haki6661/massarbeit-waage/README.md

# Maßarbeit - Waagen-Firmware

Firmware fuer eine **eigene Praezisionswaage** fuer das Maßarbeit-Trinkspiel,
basierend auf [WeighMyBru2](https://github.com/031devstudios/weighmybru2). Ein
Board macht alles: Waegezelle auslesen, BLE-Service fuer die Handy-Web-App
(siehe Schwesterprojekt "Maßarbeit App"), Anzeige.

**Zwei Geraetevarianten, eine Codebasis:** die **Maßarbeit Vision** mit TFT
und die **Maßarbeit** ohne Display. Im Code und in dieser Datei heissen sie
kurz "Vision" und "Basis".

| | Maßarbeit Vision | Maßarbeit |
|---|---|---|
| Board | LilyGO T-Display S3 (ESP32-S3, Xtensa) | LilyGO T-OI Plus V1.3 / "mini D1 PLUS" (ESP32-C3, RISC-V) |
| Anzeige | 1,9" ST7789-TFT 170x320 | eine Status-LED |
| Taster | zwei | keine (Bedienung über die App) |
| Akku | ja | ja (16340-Halter + Laderegler an Bord) |
| Build-Target | `t-display-s3` | `t-oi-plus` |
| BLE-Name | `Massarbeit-Vision` | `Massarbeit` |

Der geteilte Anteil ist gross: Waegezellen-Auswertung, das komplette
BLE-Protokoll, Firmware-Update per BLE, Kalibrierung und Deep Sleep sind
identisch - variantenspezifisch sind nur Pins, Anzeige, Tastenanzahl und der
Weckmechanismus aus dem Deep Sleep. Eine gemeinsame `.bin` kann es trotzdem
nicht geben: der S3 ist ein Xtensa-Kern, der C3 ein RISC-V - schon die
Befehlssaetze sind verschieden. Also zwei Build-Targets aus einer Codebasis
(siehe `include/BoardConfig.h`). Die App dagegen erkennt beim Verbinden
selbst, welches Modell dranhaengt (Geraete-Info-Characteristic, siehe
Abschnitt "BLE").

Die Modellkennungen (`t-display-s3`, `t-oi-plus`) benennen bewusst die
HARDWARE, nicht das Produkt: unter ihnen sucht die App im Manifest das
passende Release, sie muessen also stabil bleiben, auch wenn sich ein
Produktname wieder aendert.

Aktueller Stand: HX711-Handling + Kalibrierroutine + BLE-Gewichts-/Akkuservice
(inkl. Fernsteuerung der Anzeige durch die App, siehe Abschnitt "BLE"
weiter unten) + TFT-Anzeige mit Spieler-Badge und spielspezifischen
Away-Animationen + Pixel-Art-Sprite-Bootanimation (siehe `data/`) +
Status-LED-Anzeige derselben Zustände auf der Basis + WS2812B-Lichtleiste
(Basis) inkl. Formel-1-Startampel + Taster-Bedienung und Deep-Sleep-
Stromsparmodus (nur Vision) + Firmware-Update direkt aus der App per BLE
(kein WLAN am Partyort nötig, siehe Abschnitt "Firmware-Update per BLE"
weiter unten) + Entwicklungs-OTA per WLAN (nur Vision). Die Away-/Ergebnis-
Animationen (nicht der Boot) sind weiterhin rein prozedural aus
Linien/Kreisen/Formen, kein Sprite noetig.

**UI-Relaunch (Firmware 1.5.0):** Die TFT-Anzeige tragt jetzt dieselbe
Farbsprache wie die neu gestaltete Handy-App (dunkler Grund, ein Akzent
"Sonnenuntergang", success/danger/warning-Statusfarben - siehe
`TftDisplay::begin()`), je Spiel eine eigene Kennfarbe (statt vorher immer
Olivgruen) sowie eine kraeftige, geometrische Bold-Schrift
(`FreeSansBold10pt7b`, `include/`) fuer Spielname/Cue-Titel statt des
technischen 5x7-Pixel-Fonts. Ausserdem: die Puls-/Away-Animationen
(BEREIT/VOLLTREFFER/Away-Motive) zeichnen unveraenderliche Bildteile nur noch
einmal und radieren pro Frame nur noch die tatsaechlich bewegte Flaeche
("Dirty Rect") statt bei jedem ~150ms-Redraw den kompletten Bildschirm zu
leeren - behebt das sichtbare Schwarz-Aufblitzen waehrend laufender
Animationen.

## Hardware

Beide Varianten teilen sich HX711 + 3kg-Single-Point-Waegezelle und einen
1S-LiPo am jeweils eingebauten Laderegler. Die Pinbelegungen stehen als
Board-Profile in `include/boards/`.

### Maßarbeit Vision: LilyGO T-Display S3

| Zweck | GPIO |
|---|---|
| HX711 DOUT / SCK | 1 / 2 |
| Taste 1 (BOOT) / Taste 2 | 0 / 14 |
| Display (8-Bit-Parallelbus, siehe unten) | 5,6,7,8,9,38–48 |
| Peripherie-Power-Enable | 15 |
| Batteriespannung (ADC) | 4 |

Angeschlossen wird dabei nur der HX711 (Waegezelle) - Taster, Display, Power-
Enable und Batterie-ADC sind bereits fest auf dem Board verdrahtet:

HX711-Anschluss Maßarbeit Vision

Quelle: [Xinyuan-LilyGO/T-Display-S3](https://github.com/Xinyuan-LilyGO/T-Display-S3)
README-Pinout-Tabelle. **Wichtig:** GPIO5/6 sind bei WeighMyBru2s Original-
Boards der HX711, hier aber LCD RST/CS - deshalb HX711 auf GPIO1/2 verlegt.
Das ST7789-Display haengt an einem **8-Bit-Parallelbus** (Intel-8080-Timing),
nicht an SPI - daher `Arduino_GFX` (`Arduino_ESP32PAR8Q`-Bus) statt
`TFT_eSPI`/SPI-Displaytreiber.

### Basisvariante: LilyGO T-OI Plus V1.3 ("mini D1 PLUS")

ESP32-C3 (RISC-V), 4MB Flash, CH340C als USB-Serial-Wandler (kein nativer
USB am Chip - Serial laeuft ueber UART0), Halter fuer eine 16340-Zelle mit
Laderegler, Power-Schalter, Reset-Taster. PlatformIO-Boardprofil
`ttgo-t-oi-plus`.

| Zweck | GPIO | Anmerkung |
|---|---|---|
| HX711 DOUT / SCK | 6 / 7 | auf der Stiftleiste (MTCK/MTDO), kein Strapping-Pin |
| WS2812B-Datenleitung | 4 | über 300-500Ω, LEDs an `5V`/`GND` des Headers |
| Status-LED | 3 | Onboard (`LED_BUILTIN` der Arduino-Variante), nicht herausgefuehrt |
| Batteriespannung (ADC) | 2 | ADC1_CH2, Onboard-Spannungsteiler (Faktor 2) |

Angeschlossen werden hier der HX711 und die LED-Leiste - die Status-LED und
der Batterie-ADC haengen bereits fest am Board. **Einen Taster gibt es
nicht:** ein/aus macht der Schiebeschalter des Boards, alles andere die App.

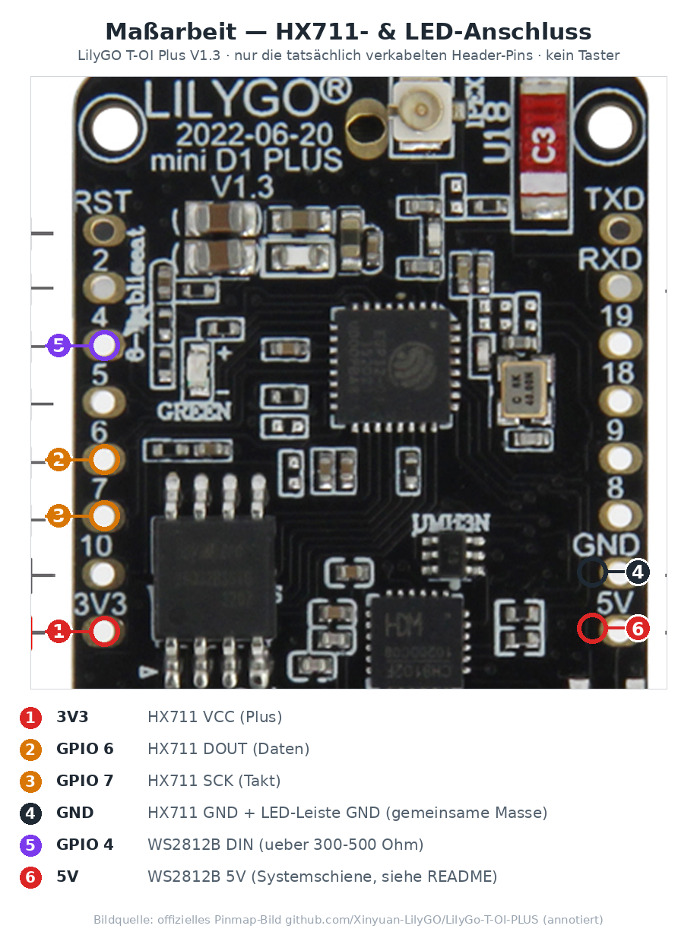
[picture p1: docs/pinout/massarbeit-basis-pinout.png]
HX711-Anschluss Maßarbeit


Quellen: [Xinyuan-LilyGO/LilyGo-T-OI-PLUS](https://github.com/Xinyuan-LilyGO/LilyGo-T-OI-PLUS)
(Pinmap-Bild + `example/battery_voltage`) und die Arduino-Variante
`ttgo-t-oi-plus` (`BAT_ADC_PIN = 2`, `LED_BUILTIN = 3`).

Drei Randbedingungen des C3 bestimmen die Pinwahl - **nicht** umsortieren,
ohne sie zu pruefen:

- **GPIO2/8/9 sind Strapping-Pins** (GPIO8 traegt auf diesem Board sogar den
  Aufdruck "Boot") - dort gehoert nichts hin, was beim Einschalten einen
  definierten Pegel erzwingt, sonst bootet der Chip womoeglich in den
  Flash-Download-Modus statt in die Firmware.
- **Nur GPIO0-5 sind RTC-faehig**, und nur die koennten aus einem Deep Sleep
  aufwecken. Fuer die Basis ist das gegenstandslos (kein Taster, kein Deep
  Sleep), aber gut zu wissen, falls die Variante das je bekommen soll:
  herausgefuehrt sind davon GPIO2, 4 und 5, und GPIO5 ist frei.
- **GPIO20/21 sind UART0** und gehen an den CH340 - freilassen, sonst ist der
  Serial-Monitor weg. (GPIO18/19, am C3 sonst der native USB, sind hier frei:
  das Board fuehrt sie als I2C/Grove heraus.)

Der C3 kennt ausserdem **kein `ext0`**: statt
`esp_sleep_enable_ext0_wakeup()` weckt ihn
`esp_deep_sleep_enable_gpio_wakeup()`, und die Aufwach-Ursache heisst
`ESP_SLEEP_WAKEUP_GPIO` statt `ESP_SLEEP_WAKEUP_EXT0` (siehe
`enterDeepSleep()`/`setup()` in `main.cpp` - dort werden beide geprueft).
Auch die `rtc_gpio_*`-Funktionen gibt es auf dem C3 nicht, Pullups laufen
ueber den normalen GPIO-Treiber.

Eine Annahme ist beim ersten Aufbau kurz gegenzupruefen und einzeilig
korrigierbar: **die LED-Polaritaet**. `MASSARBEIT_STATUS_LED_ACTIVE_LOW`
steht auf `0` (HIGH schaltet ein); leuchtet die LED genau invers zu dem, was
das Serial-Log sagt, auf `1` aendern.

## Was aus WeighMyBru2 uebernommen wurde

| Modul | Status |
|---|---|
| `Scale.h/.cpp` (HX711, Smart-Filter, NVS-Kalibrierung) | 1:1 portiert, nur FlowRate-Kopplung entfernt |
| BLE-Service (NimBLE, eigene Service-UUID) | Nur das simple "Bean Conqueror"-Float-Format uebernommen (siehe `include/Config.h`), GaggiMate-Protokoll bewusst weggelassen |
| Kalibrier-Workflow (`Faktor = Rohwert / bekanntes Gewicht`) | Logik uebernommen, ueber Serial bzw. App statt Web-Formular |
| Display, Touch-Sensoren, FlowRate, WebServer/WiFiManager, ESP-NOW-Relais | Nicht uebernommen (siehe Architektur-Ueberblick weiter oben im Chat) - fuer Maßarbeit nicht relevant |

## Projektstruktur

```
platformio.ini            <- zwei Build-Targets (+ Dev-OTA-Target)
include/
  BoardConfig.h        <- Dispatcher: waehlt das Board-Profil zur Variante
  boards/
    t_display_s3.h       <- Pins + Faehigkeiten der Vision
    t_oi_plus.h    <- Pins + Faehigkeiten der Basis
  Config.h              <- BLE-UUIDs, Kalibrier-Default, Dev-WLAN/OTA-Zugangsdaten
src/
  main.cpp              <- verdrahtet alle Module
  Scale.h/.cpp           <- HX711 (aus WeighMyBru2 portiert)
  BleWeightService.h/.cpp <- NimBLE-Service: Gewicht + Akkustand (Notify) + Tare/Anzeige-Kommandos (Write) + Geraete-Info
  Buttons.h/.cpp          <- physische Taster (OneButton-Lib), nur Vision
  DeviceUi.h              <- waehlt TftDisplay oder LedStatusUi je Variante
  DeviceUiTypes.h         <- RemoteCue/GameKind/LocalScreen (beide Varianten)
  TftDisplay.h/.cpp       <- nur Vision: Arduino_GFX-Ausgabe (Status,
                            Spieler-Badge, spielspezifische Away-Animationen,
                            Sprite-Bootanimation aus SPIFFS)
  LedStatusUi.h/.cpp      <- nur Basis: dieselben Zustaende als LED-Muster
  LedRing.h/.cpp          <- WS2812B-Lichtring im Deckel: beide Varianten,
                            vorbereitet und standardmaessig AUS
                            (siehe "LED-Ring nachruesten")
  Battery.h/.cpp          <- Akkuspannung (kalibrierter ADC, aus LilyGOs Beispiel) + Prozent-Schaetzung
  CalibrationRoutine.h/.cpp <- interaktive Kalibrierung ueber Serial
  OtaUpdater.h/.cpp        <- Firmware-Update per BLE (Chunks -> Update.h)
  DevOta.h/.cpp           <- WLAN + ArduinoOTA, nur Vision/Entwicklung
scripts/
  release.py             <- baut beide Varianten und schreibt das Manifest
data/
  f000.raw … f049.raw     <- Boot-Sprite-Frames (SPIFFS, siehe data/README.md)
  pal.raw                 <- gemeinsame 256-Farben-Palette dafuer
firmware/
  manifest.json          <- Version + Groesse + MD5 je Variante
  t-display-s3.bin        <- Release-Binary Vision (App laedt es per BLE)
  t-oi-plus.bin           <- Release-Binary Basis
```

## Bedienung

### Maßarbeit Vision (zwei Taster)

- **Taste 1** kurz: Geräte-Spielauswahl, nächstes Spiel
- **Taste 1** lang (~2s): sofort Deep Sleep (Display aus, ~wenige µA statt 60-150+ mA aktiv)
- **Taste 2** kurz: Auswahl bestätigen
- **Taste 2** lang (~1,5s): Kalibrierroutine starten (siehe unten)
- **Taste 2 drücken, während die Waage schläft**: aufwecken (kompletter Neustart der Firmware - kein spezieller Resume-Pfad, das ist bei ESP32-Deep-Sleep so vorgesehen)
- **Taste 2 beim Booten halten**: WLAN + ArduinoOTA aktivieren (nur Entwicklung, siehe unten)

Aufwecken geht bewusst nur über Taste 2 (GPIO14), nicht über Taste 1: GPIO0
(Taste 1) ist der BOOT-Strapping-Pin, wäre er beim Aufwach-Bootvorgang noch
gedrückt, könnte der Chip in den Flash-Download-Modus statt in die Firmware
starten.

### Basisvariante (ohne Taster)

Die Basis hat **keinen Taster**. Ein- und ausgeschaltet wird sie über den
Schiebeschalter des Boards, alles andere läuft über die App:

| | |
|---|---|
| Ein/Aus | Schiebeschalter des Boards (bzw. ein extern parallel dazu gelegter) |
| Tara | App, BLE-Kommando `0x01` |
| Kalibrierung | App (`0x20`/`0x21`) oder `cal` + Enter im Serial Monitor |
| LEDs | 8er-Leiste, `DIN` an GPIO4, `5V`/`GND` an den Header |
| Deep Sleep / Auto-Sleep | gibt es nicht - ohne Aufweck-Taster gäbe es keinen Weg zurück |

Der Schiebeschalter trennt die komplette System-Schiene (Zelle **und** USB),
das Gerät ist damit wirklich stromlos statt schlafend - und der Ruhestrom der
LED-Leiste ist gleich mit weg. Deep Sleep, Aufweck-Pin und Tastenlogik fallen
auf dieser Variante komplett aus dem Binary (`MASSARBEIT_BUTTON_COUNT 0`,
`Buttons.cpp` steht nicht im `build_src_filter`).

Weil das Gerät nicht mehr von selbst einschläft, übernimmt die Leiste die
Aufgabe zu zeigen, **dass die Waage überhaupt an ist**: im Leerlauf atmet sie
langsam im Akzentton und geht dabei nie ganz aus. Ohne dieses Signal wäre von
außen nicht zu erkennen, ob jemand vergessen hat einzuschalten - oder
auszuschalten, was den Akku kostet.

Eine Geräte-Spielauswahl gibt es auf der Basis nicht - ohne Display und ohne
Taster ist weder etwas anzuzeigen noch durchzuschalten. Dev-OTA per WLAN
entfällt ebenfalls (die Aktivierung hing am zweiten Taster); Firmware-Updates
laufen per BLE aus der App.

### Beide

Automatischer Deep Sleep nach 10 Minuten ohne Gewichtsänderung und ohne
Tastendruck (`AUTO_SLEEP_TIMEOUT_MS` in `include/Config.h`) - außer während
Dev-OTA aktiv ist.

Beides gilt nur für die **Vision** - die Basis hat keinen Taster und damit
auch keinen Deep Sleep, sie wird am Schiebeschalter ausgeschaltet.

Auf der Vision wird ausschließlich über einen **Taster** aufgeweckt
(Momentary gegen GND, interner Pullup), nicht über einen rastenden Schalter:
das Aufwachen läuft über den Pin-**Pegel** (`ext0`, LOW), und derselbe Pin
hängt im Betrieb an `Buttons`/OneButton. Ein Schalter, der in Stellung "ein"
stehen bleibt, hielte den Pin dauerhaft LOW - die Firmware läse das als ewig
gehaltene Taste, würde nach 2s den Langdruck auslösen, sofort einschlafen und
beim immer noch LOW liegenden Pin sofort wieder aufwachen. Ein Schalter
gehört, wenn überhaupt, in die **Batterieleitung**.

### Wie lange hält der Akku?

Im Deep Sleep zieht der ESP32 selbst nur wenige µA - die Laufzeit entscheidet
sich an allem anderen. Größter Einzelposten war der HX711: er läuft mit
~1,4-1,6mA unbeeindruckt weiter, wenn man ihn nicht ausdrücklich schlafen
legt. `enterDeepSleep()` ruft dafür `Scale::powerDown()` auf (Standby laut
Datenblatt, ~0,3µA) und friert `HX711_SCK` über den Schlaf hinweg auf HIGH
ein, damit der Standby auch hält. Auf der Basis (C3) geht dieses Einfrieren
nicht - `HX711_SCK` ist dort GPIO7 und nicht RTC-fähig; wer die volle
Standby-Zeit braucht, ergänzt einen ~10k-Pullup nach 3V3 (siehe
`t_oi_plus.h`).

Grobe Größenordnung für eine 700mAh-Zelle (davon real ~600mAh nutzbar):

| Ruhestrom | Laufzeit |
|---|---|
| ~10 µA (nur der Chip, theoretisch) | Jahre - wird nie erreicht |
| ~50-250 µA (Board-Overhead: LDO, Laderegler, Batterie-Spannungsteiler) | **~100 Tage bis ~1,4 Jahre** |
| ~1,7 mA (HX711 bliebe versorgt - so war es vor `powerDown()`) | ~2 Wochen |

Alles Datenblatt- und Erfahrungswerte, keine Messung an einem konkreten
Aufbau - der Board-Overhead schwankt je nach Revision deutlich und ist die
eine Zahl, die man wirklich nachmessen muss. Ab etwa einem halben Jahr
begrenzt ohnehin die Selbstentladung der Zelle (2-5%/Monat).

**Wichtig für den LED-Ring:** WS2812B ziehen ~0,6-1mA je LED für ihren
internen Controller, **auch wenn sie dunkel sind** - 16 LEDs sind ~10-16mA
rund um die Uhr und leeren dieselbe Zelle in unter zwei Tagen.
Dunkelschalten allein hilft dagegen nicht. Der Ring wird deshalb über
`Pins::LED_RING_POWER` (Basis GPIO10, Vision GPIO12) komplett stromlos
geschaltet - dafür braucht er einen High-Side-Schalter in seiner
5V-Zuleitung (P-MOSFET mit Gate-Pullup nach 5V + kleiner N-MOSFET als
Pegelwandler, oder ein fertiger Load-Switch). Die Polarität ist bewusst so
herum, dass ein hochohmiger GPIO - Deep Sleep, Boot, Reset - den Ring
ausschaltet.

### Was die Status-LED der Basis sagt

Die LED ist einfarbig, also trägt allein das Zeitmuster die Information
(siehe `LedStatusUi.cpp`). Ausführlicher steht alles zusätzlich im
Serial-Log, das auf der Basis den Bildschirm ersetzt.

| Zustand | Signal |
|---|---|
| Boot | schnelles Auf-/Abblenden |
| HX711 antwortet nicht oder Wägezelle fehlt (auch im Betrieb erkannt, App zeigt oben einen Hinweis) | 3 schnelle Blitze, dann Pause |
| wartet auf die App | ein kurzer Blitz alle 2s |
| verbunden, Leerlauf | Doppel-"Herzschlag" alle 3s |
| Spieler am Zug | schwaches Dauerlicht |
| "Bereit, jetzt trinken" (`0x11`) | schnelles, gleichmäßiges Blinken |
| Glas weg / Abschlag (`0x13`) | langsames Atmen |
| Volltreffer (`0x12`) | 2s Dauerlicht |
| nah dran (`0x12`) | zwei lange Blitze |
| daneben (`0x12`) | ein langer, gedimmter Blitz |

### WS2812B-Lichtleiste / -ring

Die Lichtlogik steht in `src/LedRing.h/.cpp` und ist **auf der Basis aktiv**
(erste Ausbaustufe: gerade 8er-Leiste am Werkbankaufbau), **auf der Vision
noch aus**. Ohne Freigabe im Board-Profil wirft der Compiler den gesamten
Ring-Code als toten Code weg - das ausgeschaltete Binary wächst dadurch
praktisch nicht, die Logik wird aber bei jedem Build mitkompiliert und kann
nicht unbemerkt verrotten.

**Ring oder Leiste?** `MASSARBEIT_LED_RING_IS_STRIP` im Board-Profil
entscheidet, wie sich bewegte Muster verhalten: auf dem Ring laufen sie
rundum weiter, auf einer geraden Leiste pendeln sie hin und her. Ein Punkt,
der am Ende der Leiste verschwindet und vorne wieder auftaucht, sieht dort
nach Fehler aus, nicht nach Animation. Schweiflängen, die Breite der
Startampel-Lampen und die "Einheit" der Away-Animationen (ein Viertel der
LEDs) richten sich außerdem nach `MASSARBEIT_LED_RING_COUNT` - auf acht LEDs
würde ein fester Fünf-Pixel-Schweif einfach alles ausleuchten. Deshalb hat
die Startampel vier Lampen statt fünf: vier teilt 8 und 16 glatt, jede Lampe
ist genau zwei (Leiste) bzw. vier LEDs (Ring) breit.

Der Ring **ersetzt keine der bestehenden Anzeigen**, er läuft parallel mit:
auf der Vision zusätzlich zum TFT, auf der Basis zusätzlich zur einfarbigen
Status-LED. Am BLE-Protokoll ändert sich kein Byte - `TftDisplay` und
`LedStatusUi` reichen dieselben Cue-/Spielerwechsel einfach an den Ring
weiter, die App merkt nichts davon.

**Scharfschalten einer weiteren Variante:**

1. LEDs anlöten (Verdrahtung siehe Tabelle unten): Datenleitung an
   `Pins::LED_RING_DATA`; die 5V-Zuleitung entweder fest oder über einen
   High-Side-Schalter an `Pins::LED_RING_POWER`
   (`MASSARBEIT_LED_RING_HAS_POWER_SWITCH`). Begründung der Pinwahl steht im
   jeweiligen Board-Profil.
2. Im Board-Profil `MASSARBEIT_HAS_LED_RING` auf `1`,
   `MASSARBEIT_LED_RING_COUNT` auf die tatsächliche LED-Zahl und
   `MASSARBEIT_LED_RING_IS_STRIP` auf die Geometrie setzen.

Die NeoPixel-Abhängigkeit steht bereits in `platformio.ini`; sie wird nur
dann wirklich eingebunden, wenn ein Board-Profil den Ring freigibt.

| Ring | Basis (T-OI Plus) | Vision (T-Display S3) |
|---|---|---|
| DIN (Daten) | GPIO4, über 300-500Ω | GPIO13, über 300-500Ω |
| 5V | über High-Side-Schalter, Gate an GPIO10 | über High-Side-Schalter, Gate an GPIO12 |
| GND | GND (rechter Header) | GND |

Woher die 5V kommen: der Pin heißt zwar `5V`, führt aber die System-Schiene
des Boards, nicht konstante 5V. Laut offiziellem Schaltplan
(`schematic/T-OI_PLUS_Schematic.pdf` im LilyGO-Repo) laufen beide Quellen auf
denselben Knoten und von dort über den Power-Schalter auf den Header-Pin:

```
VBUS --[D13 BAT20J Schottky]--+
                              +--[SW2 Power-Schalter]--> "5V"-Header-Pin
VBAT --[Q2 Si2307 P-MOSFET]---+                     \--> ME6211 LDO --> 3V3
```

Also ~4,7V am USB (VBUS minus Schottky) und ~3,7-4,2V im Akkubetrieb
(Zellspannung, direkt durchgeschaltet). Einen Step-up hat das Board nicht.
Für den Ring heißt das:

- **Am USB** läuft er normal.
- **Am Akku** läuft er dunkler und im Farbton leicht wärmer, unter ~3,5V
  Zellspannung wird er unzuverlässig. Nebeneffekt: das Pegelproblem
  verschwindet (die Datenleitung braucht ~0,7×VDD, bei 4,0V also 2,8V - die
  3,3V des ESP32 liegen sauber darüber), ein Level-Shifter ist unnötig.
- **Große Ringe nicht über diesen Pin speisen:** der Strom liefe sonst durch
  den kleinen Schiebeschalter SW2 auf dem Board, der dafür nicht ausgelegt
  ist. Ab etwa einem halben Ampere direkt an der Zelle abgreifen oder extern
  speisen. 32 LEDs ziehen bei Vollweiß ~1,9A - das ist ohnehin eher ein
  Netzteil-Aufbau als ein 16340-Aufbau.

Misst man am `5V`-Pin deutlich unter 3,5V, ist nicht der Pin schuld, sondern
die Zelle: entweder fast leer, oder es steckt eine **CR123A-Primärzelle** im
Halter. Die hat dieselbe Baugröße wie eine 16340, liefert aber nur ~3V und
ist **nicht ladbar** - der TP4054 an Bord würde es beim nächsten USB-Kabel
trotzdem versuchen.

Als High-Side-Schalter gibt es ein passendes Fertigmodul, das ohne ein
einziges zusätzliches Bauteil auskommt: **Pololu #2810** ("Mini MOSFET Slide
Switch with Reverse Voltage Protection, **LV**"). Zwei P-Kanal-MOSFETs,
1,8-20V, ~6A, plus Verpolungsschutz - und der `ON`-Pin ist direkt für einen
Mikrocontroller gedacht: über ~1V ein, LOW **oder nicht angeschlossen** aus.
Genau unsere Polarität, der Ring ist im Deep Sleep und beim Boot also von
selbst tot. Verdrahtung: `VIN` an die Quelle, `VOUT` an Ring-VCC, `GND` an
GND, `ON` an `Pins::LED_RING_POWER`. Der Schiebeschalter auf dem Modul liegt
parallel zum `ON`-Pin und bleibt in Stellung "aus", dann hat der GPIO allein
das Sagen. Die **LV**-Variante nehmen, nicht SV - die will ≥4,5V und stiege
im Akkubetrieb aus. Nicht verifiziert: der Ruhestrom des Moduls im
ausgeschalteten Zustand (Pololu gibt ihn nicht an) - vor der
Standby-Rechnung nachmessen.

Von den billigen "MOSFET Trigger Switch"-Modulen (IRF520, D4184) ist
abzuraten: fast alle sind Low-Side, nehmen dem Ring also den Massebezug für
die Datenleitung, und der IRF520 ist kein Logic-Level-Typ.

Diskret aufgebaut statt fertig: P-MOSFET (AO3401, DMG3415, IRLML6402 o.ä.) mit
100k-Gate-Pullup nach 5V, dessen Gate ein kleiner N-MOSFET (BSS138, 2N7002,
BS170) gegen GND zieht, sobald der GPIO HIGH wird. Der N-MOSFET schaltet nur
die ~50µA durch den Pullup, seine Ansteuerung ist also unkritisch - der
P-MOSFET trägt den ganzen Ringstrom. Ein N-MOSFET allein reicht **nicht**:
high-side kann er von 3,3V aus gar nicht schalten, und low-side (in der
GND-Leitung) hebt er den Ring-GND gegen den Board-GND an, was die
Datenleitung ihren Bezug kostet. Typen wie der BS170 sind zudem trotz
TO-92-Bequemlichkeit keine Logic-Level-Typen (V_GS(th) bis 3,0V, R_DS(on)
erst bei V_GS=10V spezifiziert) - bei 3,3V Gate-Spannung schalten sie je
nach Exemplar nur teilweise durch. In dieser Schaltung stört das nicht: der
kleine N-MOSFET zieht das Gate des P-MOSFET auf volle -5V V_GS, ein bei
-4,5V spezifizierter P-Typ reicht also. Auslegen auf den Worst Case, nicht
auf `LED_RING_MAX_BRIGHTNESS`: 16 LEDs sind bei Vollweiß ~1A, 32 LEDs ~1,9A.

**Vor dem Festlöten prüfen:** ESP32-GPIOs geben 3,3V aus, WS2812B sind für
5V-Logik spezifiziert (kurze Leitungen laufen meist trotzdem, sicher ist ein
Level-Shifter); 300-500Ω in die Datenleitung, ~1000µF über die 5V-Versorgung
des Rings. Woher die 5V kommen, steht weiter oben - auf der Basis ist es die
System-Schiene des Boards, im Akkubetrieb also Zellspannung. Die harte
Helligkeitsobergrenze `LED_RING_MAX_BRIGHTNESS` (`include/Config.h`, Vorgabe
40/255) sitzt bewusst in `LedRing::show()`, also an der einzigen Stelle, die
wirklich Strom schaltet - bei Vollweiß zieht jede LED sonst bis zu ~60mA.

**Was der Ring zeigt** (Reihenfolge = Priorität, dieselbe Rangfolge wie die
Status-LED der Basis):

| Zustand | Lichtbild |
|---|---|
| Startampel Formel 1 | vier rote Lampen à zwei LEDs gehen im App-Takt nacheinander an, bleiben stehen und schalten gemeinsam auf Grün - Grün bleibt, bis das Glas abgehoben ist |
| Fehlstart / Abbruch | rotes Warnblinken |
| HX711 antwortet nicht oder Wägezelle fehlt | drei rote Blitze rundum |
| "Bereit, jetzt trinken" (`0x11`) | ruhiger grüner Puls, nie ganz dunkel |
| Glas weg / Abschlag (`0x13`) | spielabhängig und im selben Takt wie die Away-Animation der App: Golf fliegender Ball (1,4 s), Dart beschleunigender Pfeil mit Einschlag (1,1 s), Blackjack Karte für Karte mit Umdrehen (1,3 s je Karte), Wackelturm gezogener Block wandert nach oben (1,6 s), Boxen Handschuh trifft Sandsack (1,3 s), sonst ruhiger Komet |
| Volltreffer (`0x12`) | grüner Grund mit schnellem weißem Umlauf |
| nah dran (`0x12`) | zwei lange gelbe Blitze |
| daneben (`0x12`) | ein langsam abfallendes Rot |
| Gewicht auf der Waage | Balken in Spieler-/Spielfarbe, wächst mit dem Gewicht (Vollausschlag bei `LED_RING_WEIGH_FULL_SCALE_G`, Vorgabe 400g) |
| Spieler am Zug | langsames Atmen in der Spielerfarbe (`0x14`) |
| wartet auf die App | einzelner blauer Punkt wandert (auf einer geraden Leiste hin und her, auf einem Ring rundum) |
| verbunden, alles in Ordnung, kein Spiel läuft | Regenbogen-Lauf über die ganze Leiste (ein Farbumlauf alle 3 s, von links nach rechts) - das "die Waage ist an und bereit"-Signal |

Der Wiege-Balken ist das einzige Muster, das es weder auf dem TFT noch auf
der Status-LED gibt: beim Einschenken schaut man aufs Glas, nicht aufs
Display - ein wachsender Lichtbogen im Deckel liegt genau im Blickfeld.

Die Startampel läuft: die App löst sie per BLE aus (`0x30`/`0x31`/`0x32`,
siehe Abschnitt "BLE") und schickt beim Aufstellen des Glases die ausgeloste
Haltezeit samt Lampentakt und -zahl mit - die Waage zählt die Lampen dann
selbst im selben Takt wie der Bildschirm herunter und geht ohne weiteres
Kommando auf Grün, im selben Moment wie die App. Der umgekehrte Weg ist ebenfalls vorgesehen:
`0x30` mit `holdMs = 0` lässt die Lampen stehen, bis die App `0x31` schickt.
Auf dem TFT der Vision fehlt die Ampel noch (siehe `ROADMAP.md`, "Formel 1
auf der Vision (TFT) nachziehen").

## Kalibrieren (Schritt 4 - mit der 3kg-Zelle neu ermitteln)

1. Serial Monitor oeffnen (115200 Baud).
2. Kalibrierung starten: Vision Taste 2 ca. 1,5s halten, Basis `cal` + Enter
   im Serial Monitor tippen - bis "Kalibrierung gestartet" erscheint.
   (Beides geht auch aus der App, siehe BLE-Kommandos `0x20`/`0x21`.)
3. Waage leeren, Enter im Serial Monitor druecken.
4. Bekanntes Referenzgewicht auflegen, dessen Gramm-Zahl eingeben (z.B. `500`), Enter druecken.
5. Neuer Kalibrierfaktor wird berechnet, geloggt, auf der Geraeteanzeige
   gezeigt (auf der Basis nur ueber Serial) und automatisch im NVS gespeichert (`Preferences`, Namespace `scale`, Key
   `calib`) - `DEFAULT_CALIBRATION_FACTOR` in `include/Config.h` wird danach
   nicht mehr verwendet.

## BLE

Service-/Characteristic-UUIDs stehen in `include/Config.h` (Herkunft dort
dokumentiert). Eine Notify-Characteristic liefert das Gewicht als simplen
4-Byte-Little-Endian-Float in Gramm (~20x/s), eine zweite liefert den
Akkustand als 1 Byte (0-100 = Prozent, `0xFF` = kein verlässlicher Wert,
z.B. USB gesteckt - siehe `Battery::readPercent()`), alle 5s (Akkustand
ändert sich langsam, spart Funkverkehr). Eine Read-Characteristic liefert die
Firmware-Version als UTF-8-String (`FIRMWARE_VERSION`) - damit erkennt die
App, ob ein Update verfügbar ist (siehe "Firmware-Update per BLE" weiter
unten). Eine weitere Read-Characteristic (`6E40000A-…`) liefert Modell und
Fähigkeiten als UTF-8-JSON:

```json
{"model":"t-oi-plus","name":"Massarbeit","fw":"1.10.0",
 "variant":"t-oi-plus",
 "caps":{"display":false,"battery":true,"buttons":0,"led":true,"ota":true}}
```

Daran erkennt die App beim Verbinden, welches Modell dranhängt, und stellt
sich darauf ein (Modellname statt pauschal "Waage verbunden", passende
Firmware-Variante beim Update, keine Texte, die ein Display voraussetzen).
JSON statt einer Byte-Bitmaske ist Absicht: es lässt sich um ein Feld
erweitern, ohne dass App und Firmware gleichzeitig aktualisiert werden
müssen. Fehlt die Characteristic (ältere Firmware), nimmt die App "Vision
mit Display" an - alte Geräte funktionieren unverändert weiter.

Eine Write-Characteristic nimmt Kommandos entgegen:

| Byte(s) | Bedeutung |
|---|---|
| `0x01` | Tare |
| `0x10` | Display zurück auf normale Gewichtsanzeige |
| `0x11` | Display zeigt "Bereit, jetzt trinken" (Turn-Readiness-Ritual der App) |
| `0x12 <Güte>` | Display zeigt Ergebnis-Rückmeldung: `0`=daneben, `1`=nah dran, `2`=Volltreffer |
| `0x13 <gameId>` | Display zeigt spielspezifische "Glas ist weg"-Animation (Golf/Dart/Blackjack/Tower — Glas komplett von der Waage gehoben, App-seitige `useSipDetector`-"away"-Phase) |
| `0x14 <gameId><r><g><b><nameLen><name>` | Zug gestartet: Namens-/Farb-Badge + Spiel-Icon oben auf dem Gewichtsscreen |
| `0x15` | Zug beendet - Badge weg |

`gameId`: `0`=keins, `1`=Golf, `2`=Dart, `3`=Blackjack, `4`=Tower, `5`=Scale
(siehe `GameKind` in `DeviceUiTypes.h`). `0x10`-`0x15` lösen keine eigene
Gewichtslogik aus - die Waage kennt kein Spielkonzept, sie zeigt nur, was
die App ihr sagt (siehe `RemoteCue`/`DeviceUi::setActivePlayer()`). Die
Kommandos sind für beide Varianten identisch - die Basis rendert sie eben
als LED-Muster statt als Vollbild-Animation, die App muss davon nichts
wissen. Die
Away-/Ergebnis-Animationen sind rein prozedural (Linien/Kreise/Formen),
nur die Bootanimation nutzt echte Pixel-Art-Sprites (siehe `data/`).

## Bauen & Flashen

```
pio run -e t-display-s3 -t upload          # Vision, ueber USB-C
```

```
pio run -e t-oi-plus -t upload   # Basisvariante, ueber USB
```

```
pio device monitor
```

Welche Variante gebaut wird, entscheidet allein das Environment: es setzt
`-DMASSARBEIT_VARIANT_VISION` bzw. `-DMASSARBEIT_VARIANT_BASE`, woraufhin
`include/BoardConfig.h` das passende Board-Profil einbindet. Fehlt das Flag,
bricht der Build mit einer `#error`-Meldung ab, statt still etwas Falsches
zu bauen.

Nur Vision: die Boot-Sprite-Frames (`data/`) liegen auf einer eigenen
SPIFFS-Partition (siehe `platformio.ini`, `board_build.filesystem = spiffs`)
und werden vom normalen Firmware-Flash NICHT mit übertragen - nur nötig, wenn
sich an `data/` etwas ändert (nicht bei jedem Code-Flash). Die Basis hat
weder Sprites noch SPIFFS:

```
pio run -e t-display-s3 -t uploadfs --upload-port <PORT>
```

## Firmware-Update per BLE (aus der App)

Die "Maßarbeit App" hat unter Einstellungen einen "Firmware"-Bereich: sie
lädt `firmware/manifest.json` + die zum verbundenen Modell passende `.bin`
aus diesem Repo per `raw.githubusercontent.com` herunter (kein Backend, kein
Token nötig - das Repo ist public) und überträgt sie in Chunks
(`OtaUpdater.h`) direkt per Bluetooth an die Waage. Welche `.bin` die
richtige ist, sagt die Geräte-Info-Characteristic (`variant`, siehe
Abschnitt "BLE") - eine S3-Firmware landet also nie auf einer Basis. Kein WLAN am Partyort nötig - nur das Handy braucht
Internet zum Herunterladen.

**Schutz vor der falschen Variante:** die Waage prüft am Anfang der
Übertragung die Chip-Kennung im Image-Header (Byte 12/13, `0x0009` =
ESP32-S3, `0x0005` = ESP32-C3) gegen den Chip, auf dem sie selbst läuft, und
lehnt ein fremdes Image sofort ab (`ChipMismatch`, Fehlercode 6 in
`OtaUpdater.h`). Die Auswahl der richtigen `.bin` trifft zwar die App anhand
der Geräte-Info — aber wenn dabei etwas schiefgeht (alte App im
Browser-Cache, unlesbare Characteristic), soll das Gerät nicht erst beim
Booten scheitern, sondern das Update ablehnen, solange die alte Firmware
noch unangetastet läuft.

Sicherheitsmechanismus: die neue Firmware landet in der inaktiven
OTA-Partition (`app0`/`app1`, siehe Board-Partitionstabelle). Erst wenn
Größe UND MD5 exakt passen, schaltet `Update.end(true)` die Waage beim
nächsten Neustart auf die neue Partition um. Bricht die Übertragung ab
(Verbindungsverlust, falsche Prüfsumme, Timeout), bleibt unverändert die
bisherige Firmware aktiv - die Waage kann durch ein fehlgeschlagenes
Update nicht "gebrickt" werden.

**Wichtig:** Ein App-BLE-Update überträgt nur die App-Partition, nie die
SPIFFS-Partition (`data/`, siehe unten). Ein Gerät, das per BLE von
einer Firmware ohne Sprite-Bootanimation aktualisiert wird, bootet danach
zwar sofort mit dem neuen Code, zeigt aber (bis einmal per USB + `pio run
-t uploadfs` die Frames übertragen wurden) keine Bootanimation - fällt
sauber auf einen leeren Screen für die `MIN_VISIBLE_MS`-Mindestdauer zurück,
kein Hänger.

### Release bauen

**Automatisch (Standardweg):** `FIRMWARE_VERSION` in `include/Config.h`
hochzählen (bewusst von Hand - das zählt nichts automatisch hoch), committen
und auf `main` pushen. Der Workflow `.github/workflows/release-firmware.yml`
baut daraufhin beide Varianten, aktualisiert `firmware/manifest.json` +
`firmware/*.bin` und committet/pusht das Ergebnis selbst zurück auf `main` -
die App erkennt das neue Manifest beim nächsten Öffnen der Einstellungen.
Lässt sich auch ohne Versionsänderung manuell anstoßen (GitHub → Actions →
"Firmware-Release bauen" → "Run workflow").

**Von Hand** (z.B. ohne Internetzugriff auf GitHub Actions, oder um vor dem
Push lokal zu prüfen):

```bash
python scripts/release.py
```

Das baut beide Varianten, kopiert die Binaries nach `firmware/`, rechnet
Größe + MD5 aus und schreibt beides in `firmware/manifest.json`. Nur eine
Variante geht auch: `python scripts/release.py t-oi-plus`; der Eintrag der
anderen bleibt dabei erhalten. Anschließend wie gewohnt committen + auf
`main` pushen.

Der frühere 5-Schritte-Handbetrieb (bauen, `md5sum`, kopieren, Manifest von
Hand pflegen) war schon mit einer Variante fehleranfällig und wird mit zweien
unzumutbar: ein vergessener MD5 fällt erst am Gerät auf, wenn das Update
heruntergeladen, geprüft und verworfen wurde.

**Manifest-Format:** `variants` ordnet jeder Modell-Kennung (dem `variant`
aus der Geräte-Info) ihre Datei zu. Die alten Top-Level-Felder
(`version`/`file`/`size`/`md5`) bleiben zusätzlich als Spiegel der
S3-Variante bestehen, damit ein alter, im Browser gecachter App-Stand nicht
kaputtgeht.

## Entwicklungs-OTA

Nur fuer die Entwicklungsphase, wenn direkt am Code gearbeitet wird (fuer
fertige Releases an die Party-Waage siehe "Firmware-Update per BLE" oben -
siehe `src/DevOta.h` fuer den Hintergrund). **Nur Vision:** der Basis
fehlt der zweite Taster fuer die Aktivierung, dort sind alle DevOta-Methoden
leere Attrappen und der WLAN-Code faellt komplett aus dem Binary.

1. In `include/Config.h` `DEV_WIFI_SSID`/`DEV_WIFI_PASSWORD` eintragen (nicht committen, falls das Repo geteilt wird).
2. Board per USB flashen, dabei **Taste 2 gedrueckt halten**, bis "Aktiviere WLAN + ArduinoOTA" im Serial-Log erscheint.
3. IP-Adresse aus dem Serial-Log ablesen.
4. Danach kabellos updaten:
   ```
   pio run -e t-display-s3-ota -t upload --upload-port <IP>
   ```

Ohne gehaltene Taste 2 beim Boot bleibt WLAN komplett aus (Akkuschonung im
normalen Party-Betrieb).
