haki6661/massarbeit-waage/animation/boot.gif

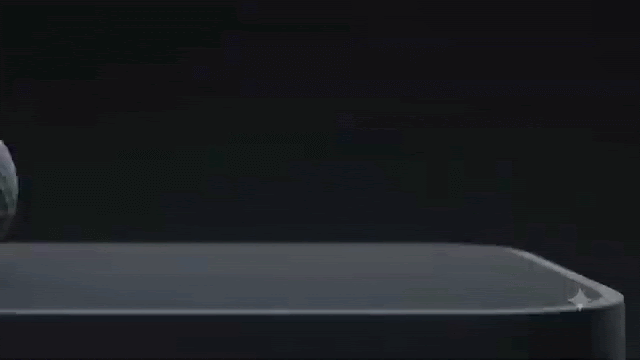
animation/boot.gif
