haki6661/massarbeit-waage/cad/preview.png

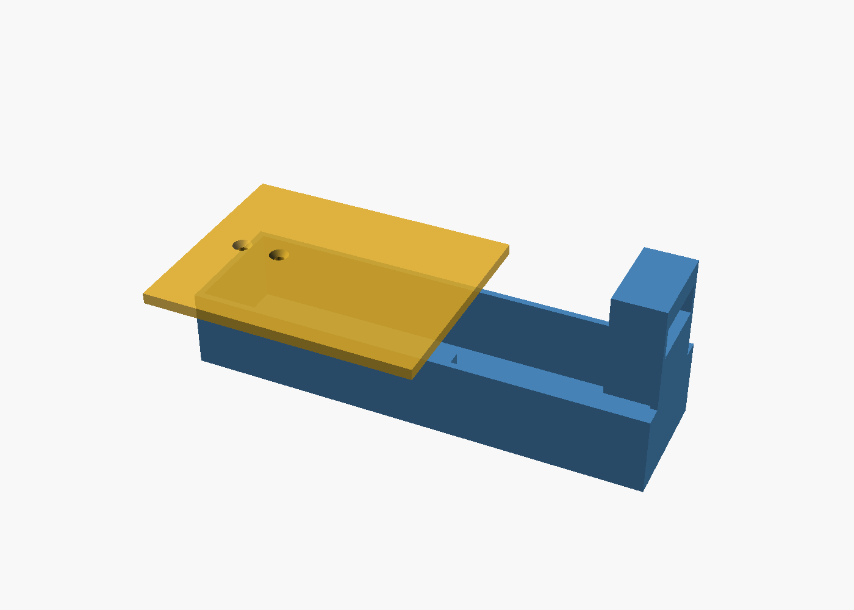
cad/preview.png
