haki6661/massarbeit-waage/cad/massarbeit_waage_platform.stl

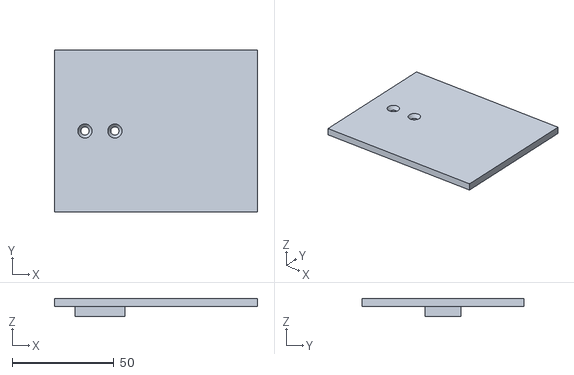
[picture p4: CAD file, 2026-08-30]
cad/massarbeit_waage_platform.stl
100.0 x 80.0 x 9.10
