haki6661/massarbeit-waage/src/Scale.h

#pragma once

// Portiert aus WeighMyBru2 (https://github.com/031devstudios/weighmybru2,
// include/Scale.h + src/Scale.cpp) - HX711-Handling, Smart-Filter und
// NVS-Kalibrierung sind board-unabhaengig und wurden fast 1:1 uebernommen.
// Entfernt wurde nur die FlowRate-Kopplung (Espresso-Flussraten-Berechnung
// pausieren waehrend des Tarierens) - fuer Maßarbeit nicht relevant.

#include <HX711.h>
#include <Preferences.h>

// Zustand der Messkette, laufend in getWeight() ueberwacht und per BLE als
// Statusbyte hinter jedem Gewichtswert an die App gemeldet (siehe
// BLE_WEIGHT_CHAR_UUID in Config.h) - die Werte sind damit Protokoll und
// duerfen sich nicht verschieben.
enum class SensorStatus : uint8_t {
    Ok = 0,
    // HX711 antwortet nicht: nie gefunden, im Betrieb verstummt (DOUT bleibt
    // HIGH) oder liefert nur noch glatte Nullen (DOUT haengt auf LOW).
    Hx711Missing = 1,
    // HX711 antwortet, aber die Waegezelle fehlt: mit offenen Eingaengen
    // laeuft der ADC an den Anschlag (+/-2^23). Mit angeschlossener Zelle
    // kommt das nie vor - selbst die volle Last der 3kg-Zelle nutzt nur
    // knapp die Haelfte des Messbereichs.
    LoadCellMissing = 2,
};

class Scale {
public:
    Scale(uint8_t dataPin, uint8_t clockPin, float calibrationFactor);

    bool begin(); // false, wenn der HX711 nicht antwortet
    void tare(uint8_t times = 20);

    // Schickt den HX711 in den Standby (~0.3µA statt ~1.4-1.6mA) - vor dem
    // Deep Sleep aufzurufen, siehe enterDeepSleep() in main.cpp.
    //
    // Warum das ueberhaupt zaehlt: der schlafende ESP32 zieht nur wenige µA,
    // der HX711 aber laeuft voellig unbeeindruckt weiter und ist damit im
    // Schlaf der mit Abstand groesste Verbraucher der ganzen Schaltung. An
    // einer 700mAh-Zelle sind das der Unterschied zwischen rund zwei Wochen
    // und mehreren Monaten Standby.
    //
    // Kein Gegenstueck powerUp() noetig: aus dem Deep Sleep kommt die Waage
    // ueber einen kompletten Neustart zurueck (kein Resume-Pfad), und
    // Scale::begin() weckt den HX711 mit dem ersten Takt ohnehin wieder auf.
    void powerDown();
    void set_scale(float factor); // setzt + speichert den Kalibrierfaktor (NVS)

    float getWeight();        // gefiltertes Gewicht, max. 1x/20ms neu berechnet
    float getCurrentWeight(); // letzter gefilterter Wert, ohne neue Messung
    long  getRawValue();      // unkalibrierter Rohwert (Mittel aus 10 Messungen) - fuer die Kalibrierroutine

    // Letzter unkalibrierter, ungefilterter Messwert aus getWeight() (in
    // "Gramm" bei aktuellem Kalibrierfaktor) - fuer die Debug-Anzeige, um
    // ohne extra HX711-Zugriff zu sehen, dass sich ueberhaupt was tut.
    float getLastRawReading() const { return lastRawReading; }

    float getCalibrationFactor() const { return calibrationFactor; }
    bool  isHX711Connected() const { return isConnected; }

    // Gesamtzustand fuer Anzeige und App: HX711 da UND Waegezelle da.
    // isHX711Connected() allein reicht dafuer nicht - ohne Zelle antwortet
    // der HX711 weiter brav, liefert aber nur Anschlagwerte.
    SensorStatus sensorStatus() const {
        if (!isConnected) return SensorStatus::Hx711Missing;
        return loadCellMissing ? SensorStatus::LoadCellMissing : SensorStatus::Ok;
    }
    bool isSensorOk() const { return sensorStatus() == SensorStatus::Ok; }

private:
    HX711 hx711;
    Preferences preferences;
    uint8_t dataPin;
    uint8_t clockPin;
    float calibrationFactor;
    float currentWeight;
    float lastRawReading = 0.0f;
    bool isConnected = false;

    // --- Laufzeit-Ueberwachung der Messkette (siehe SensorStatus) ---------
    // Bisher wurde der HX711 nur einmal beim Booten geprueft: ein im Betrieb
    // abgezogener HX711 liess das zuletzt gemessene Gewicht einfach stehen,
    // eine fehlende Waegezelle fiel gar nicht auf (die Anschlagwerte gingen
    // als absurde Gewichte an die App). Die Grenzen sind bewusst grosszuegig:
    // ein Fehlalarm mitten im Spiel waere schlimmer als eine Sekunde Verzug.
    //
    // Ab hier gilt ein Rohwert als "am Anschlag" (Grenze +/-8388607).
    static constexpr long SATURATION_RAW = 8300000L;
    // So lange ohne neuen Messwert (DOUT bleibt HIGH), bis der HX711 als
    // verloren gilt - der HX711 misst mit 10 oder 80 Hz, 1.5s sind also
    // mindestens 15 verpasste Messungen.
    static constexpr unsigned long HX711_LOST_TIMEOUT_MS = 1500;
    // So viele Nullen in Folge (DOUT haengt auf LOW) = HX711 weg. Ein
    // echter Rohwert von exakt 0 kommt vor, zehnmal hintereinander nicht.
    static const int ZERO_READINGS_LOST = 10;
    // So lange muessen die Rohwerte ununterbrochen am Anschlag stehen, bis
    // die Waegezelle als fehlend gilt.
    static constexpr unsigned long LOAD_CELL_MISSING_AFTER_MS = 1000;
    // Wie oft ein fehlender HX711 neu gesucht wird (wieder angesteckt).
    static constexpr unsigned long RECONNECT_INTERVAL_MS = 2000;

    unsigned long lastReadyMs = 0;
    unsigned long lastReconnectAttemptMs = 0;
    unsigned long saturatedSinceMs = 0; // 0 = gerade nicht am Anschlag
    int zeroReadings = 0;
    bool loadCellMissing = false;

    void markHx711Lost(const char* reason);
    void tryReconnect(unsigned long now);

    // "Der HX711 hat gerade geantwortet" - gehoert an JEDE Stelle, die den
    // Chip direkt liest, nicht nur in getWeight(). Sonst haelt die Waage ihre
    // eigenen, blockierenden Messungen fuer "der Chip ist verstummt":
    // hx711.tare(20) dauert bei 10 SPS gemessene 1838ms und getRawValue()
    // (= get_value(10)) knapp eine Sekunde - beide laenger als
    // HX711_LOST_TIMEOUT_MS, und beide stempelten frueher nicht.
    //
    // Im Live-Log vom 10.09. sah das so aus: jede App-Tara loeste unmittelbar
    // "HX711 verloren" aus, und im Eich-Bildschirm der App (der den Rohwert
    // dreimal pro Sekunde anfordert) lief die Waage dauerhaft im Takt
    // "verloren -> wieder da -> verloren" - Fehlerbanner in der App, drei rote
    // Blitze auf dem Ring, obwohl der HX711 fest verloetet war und
    // einwandfrei mass.
    void noteHx711Responded() { lastReadyMs = millis(); }

    void saveCalibration();

    // Smart-Filter: waehrend "Brewing"-artiger Aktivitaet (schnelle Aenderung)
    // Median, sonst gleitender Durchschnitt - reduziert Rauschen ohne bei
    // schnellen Gewichtsaenderungen hinterherzuhinken. Fuer Maßarbeit reicht
    // das genauso gut wie fuers Espresso-Brauen.
    static const int MAX_SAMPLES = 10;
    float readings[MAX_SAMPLES] = {};
    int readingIndex = 0;
    bool samplesInitialized = false;

    enum FilterState { STABLE, BREWING, TRANSITIONING };
    FilterState currentFilterState = STABLE;
    unsigned long lastActivity = 0;

    // War 0.2g - lag deutlich UNTER dem normalen Einzelsample-Rauschen von
    // HX711+Waegezelle (per Live-Test ca. +/-1-3g, siehe Commit-Historie).
    // Ergebnis: der Filter blieb dauerhaft im BREWING-Zustand (ganz normales
    // Rauschen wurde staendig als "Aktivitaet" gewertet) und erreichte nie
    // STABLE - wodurch auch die Auto-Zero-Nachfuehrung (an STABLE gekoppelt,
    // s.u.) faktisch nie griff und sich Drift ueber mehrere Minuten
    // unbemerkt aufaddieren konnte. Jetzt bewusst ueber dem beobachteten
    // Rauschband, aber weit unter jedem echten Glas/Objekt (>>5g, siehe
    // "grosse Spruenge sofort uebernehmen" unten).
    static constexpr float ACTIVITY_THRESHOLD = 4.0f;      // g Aenderung, die als "Aktivitaet" zaehlt
    static constexpr unsigned long STABILITY_TIMEOUT = 2000; // ms Ruhe, bis wieder als stabil gilt
    static const int MEDIAN_SAMPLES = 3;
    static const int AVERAGE_SAMPLES = 2;

    // Auto-Zero-Nachfuehrung: HX711/Waegezelle driften nach dem Einschalten
    // spuerbar (thermisches Einschwingen ueber mehrere Minuten, typisch fuer
    // guenstige Zellen) - ohne Gegenmassnahme wandert die Anzeige bei leerer
    // Waage langsam von 0g weg, auch ganz ohne Aktivitaet. Loesung wie bei
    // echten Kuechen-/Briefwaagen ueblich: liegt der gefilterte Wert laenger
    // als AUTO_ZERO_INTERVAL_MS ruhig innerhalb eines kleinen Bands um Null,
    // automatisch nachtarieren (siehe getWeight()) - faengt die Drift
    // periodisch ab, ohne ein absichtlich aufgestelltes Glas zu beeinflussen
    // (die sind alle deutlich schwerer als das Band).
    // Band bewusst grosszuegig (aber weit unter jedem echten Glas/Becher,
    // siehe MockWeightSource im App-Repo: 220-400g) UND Intervall bewusst
    // kurz - sonst kann die Drift aus dem Band herauslaufen, bevor
    // ueberhaupt einmal nachgetart wurde, und faengt sich danach nie wieder
    // ein (die Pruefung unten greift nur INNERHALB des Bands).
    static constexpr float AUTO_ZERO_BAND_G = 10.0f;
    static constexpr unsigned long AUTO_ZERO_INTERVAL_MS = 8000;
    unsigned long lastAutoZeroMs = 0;

    // Schock-Nullpunkt-Korrektur: guenstige Single-Point-Waegezellen koennen
    // bei ruckartiger Entlastung (Glas schnell hochreissen - genau die im
    // Partyspiel gewuenschte Bewegung, siehe Live-Test 30.08.) einen
    // spuerbaren Nullpunkt-Versatz "einfrieren", der weit ausserhalb von
    // AUTO_ZERO_BAND_G liegt und sich ohne Gegenmassnahme NIE wieder
    // von selbst erholt (beobachtet: -175g dauerhaft haengengeblieben,
    // trotz mehrfachem Auf-/Abladen danach). Ein stabil eingependelter
    // NEGATIVER Wert ist aber immer eindeutig falsch - nichts auf der
    // Waage kann negativ wiegen -, also risikolos sofort korrigierbar,
    // ohne auf AUTO_ZERO_INTERVAL_MS zu warten (das Intervall schuetzt nur
    // vor faelschlichem Wegtarieren eines leichten, absichtlich
    // aufgestellten Objekts - bei einem negativen Wert kann das per
    // Definition nicht der Fall sein).
    //
    // Wartet NICHT auf den vollen Smart-Filter-STABLE-Zustand (der braucht
    // BREWING(2s) + TRANSITIONING(2s) = ca. 6s Ruhe, viel zu lange fuers
    // Partyspiel - Live-Test 30.08.: -120g blieb spuerbar lange sichtbar
    // stehen). Nutzt stattdessen einen eigenen, viel kuerzeren Ruhe-Check
    // (NEGATIVE_DRIFT_SETTLE_MS) direkt auf lastActivity - reicht als
    // Absicherung gegen das mechanische Nachschwingen, ist aber deutlich
    // schneller. Wichtig auch fuers App-seitige Ritual: die Korrektur selbst
    // ist ein abrupter Sprung (z.B. -120g -> 0g) - je laenger das
    // Zeitfenster bis zur Korrektur, desto groesser die Chance, dass er
    // zufaellig mit einer echten Gewichtsaenderung zusammenfaellt und sich
    // beide zu einem viel zu grossen Wert addieren (beobachtet: ein
    // kleiner Schluck wurde durch so eine Ueberschneidung als 140g
    // gewertet).
    static constexpr float NEGATIVE_DRIFT_THRESHOLD_G = -2.0f;
    static constexpr unsigned long NEGATIVE_DRIFT_SETTLE_MS = 1000;

    void initializeSamples(float initialValue);
    float medianFilter(int samples);
    float averageFilter(int samples);
};
