haki6661/massarbeit-waage/docs/pinout/src/generate_basis.py

"""Erzeugt docs/pinout/massarbeit-basis-pinout.png aus dem offiziellen
LilyGO-Pinmap-Bild (t-oi-plus-official.png, in diesem Ordner).

Pixelkoordinaten der Pads wurden durch Analyse des Original-Bilds ermittelt
(Header-Pins "4"/"6"/"7"/"3V3" links, "GND"/"5V" rechts). Bei einer neuen
Bild-Revision von LilyGO muessen sie neu bestimmt werden.

Ausfuehren aus docs/pinout/src/:  python generate_basis.py
"""

import os

from PIL import Image, ImageDraw, ImageFont

# Windows-Schriften, wenn vorhanden - sonst DejaVu (Linux/CI). Nur die
# Beschriftung sieht dann minimal anders aus, die Koordinaten bleiben gleich.
def _font(bold, size):
    candidates = [
        f"C:/Windows/Fonts/{'arialbd' if bold else 'arial'}.ttf",
        f"/usr/share/fonts/truetype/dejavu/DejaVuSans{'-Bold' if bold else ''}.ttf",
    ]
    for path in candidates:
        if os.path.exists(path):
            return ImageFont.truetype(path, size)
    return ImageFont.load_default()

src = Image.open("t-oi-plus-official.png").convert("RGB")

box = (1150, 600, 2500, 1900)
scale = 0.62
crop = src.crop(box)
crop = crop.resize((int(crop.width * scale), int(crop.height * scale)), Image.LANCZOS)


def tx(pt):
    x, y = pt
    return ((x - box[0]) * scale, (y - box[1]) * scale)


# Badge-Nummer, Pad-Koordinate im Original, Farbe
pins = [
    ("1", (1308, 1778), "#dc2626"),  # 3V3 -> HX711 VCC
    ("2", (1308, 1413), "#d97706"),  # GPIO6 -> HX711 DOUT
    ("3", (1308, 1533), "#d97706"),  # GPIO7 -> HX711 SCK
    ("4", (2342, 1652), "#1f2933"),  # GND (rechter Header) -> HX711 GND + LED GND
    ("5", (1308, 1171), "#7c3aed"),  # GPIO4 -> WS2812B DIN
    ("6", (2342, 1772), "#dc2626"),  # 5V (rechter Header) -> WS2812B 5V
]

d = ImageDraw.Draw(crop)
font_badge = _font(True, 24)
for num, pt, color in pins:
    cx, cy = tx(pt)
    r = 20
    d.ellipse([cx - r, cy - r, cx + r, cy + r], outline=color, width=6)
    right_side = num in ("4", "6")  # rechter Header -> Badge nach rechts
    bx = cx + 60 if right_side else cx - 60
    by = cy
    br = 18
    d.ellipse([bx - br, by - br, bx + br, by + br], fill=color, outline="#ffffff", width=3)
    tb = d.textbbox((0, 0), num, font=font_badge)
    tw, th = tb[2] - tb[0], tb[3] - tb[1]
    d.text((bx - tw / 2 - tb[0], by - th / 2 - tb[1]), num, font=font_badge, fill="#ffffff")
    edge_x = cx + r if right_side else cx - r
    d.line([bx - br, by, edge_x, cy], fill=color, width=4)

# ---- Gesamtcanvas: Titel + Bild + Legende + Fussnote ----
W = max(crop.width + 80, 760)
title_h, legend_h, footer_h = 100, 285, 60
H = title_h + crop.height + legend_h + footer_h

canvas = Image.new("RGB", (W, H), "#ffffff")
cd = ImageDraw.Draw(canvas)
font_title = _font(True, 30)
font_sub = _font(False, 18)
font_legend_num = _font(True, 20)
font_legend = _font(False, 20)
font_footer = _font(False, 15)

title = "Maßarbeit — HX711- & LED-Anschluss"
sub = "LilyGO T-OI Plus V1.3 · nur die tatsächlich verkabelten Header-Pins · kein Taster"
tb = cd.textbbox((0, 0), title, font=font_title)
cd.text(((W - (tb[2] - tb[0])) / 2, 24), title, font=font_title, fill="#1f2933")
sb = cd.textbbox((0, 0), sub, font=font_sub)
cd.text(((W - (sb[2] - sb[0])) / 2, 62), sub, font=font_sub, fill="#52606d")

img_x = (W - crop.width) // 2
canvas.paste(crop, (img_x, title_h))
cd.rectangle([img_x, title_h, img_x + crop.width, title_h + crop.height], outline="#d1d5db", width=1)

legend = [
    ("1", "#dc2626", "3V3", "HX711 VCC (Plus)"),
    ("2", "#d97706", "GPIO 6", "HX711 DOUT (Daten)"),
    ("3", "#d97706", "GPIO 7", "HX711 SCK (Takt)"),
    ("4", "#1f2933", "GND", "HX711 GND + LED-Leiste GND (gemeinsame Masse)"),
    ("5", "#7c3aed", "GPIO 4", "WS2812B DIN (ueber 300-500 Ohm)"),
    ("6", "#dc2626", "5V", "WS2812B 5V (Systemschiene, siehe README)"),
]
ly = title_h + crop.height + 24
for num, color, pinname, desc in legend:
    bx, by = 40, ly + 14
    br = 16
    cd.ellipse([bx - br, by - br, bx + br, by + br], fill=color, outline="#ffffff", width=2)
    tb2 = cd.textbbox((0, 0), num, font=font_legend_num)
    cd.text((bx - (tb2[2] - tb2[0]) / 2 - tb2[0], by - (tb2[3] - tb2[1]) / 2 - tb2[1]), num, font=font_legend_num, fill="#ffffff")
    cd.text((bx + 34, by - 13), pinname, font=font_legend_num, fill="#1f2933")
    cd.text((bx + 34 + 120, by - 13), desc, font=font_legend, fill="#52606d")
    ly += 42

fy = title_h + crop.height + legend_h + 10
footer = "Bildquelle: offizielles Pinmap-Bild github.com/Xinyuan-LilyGO/LilyGo-T-OI-PLUS (annotiert)"
fb = cd.textbbox((0, 0), footer, font=font_footer)
cd.text(((W - (fb[2] - fb[0])) / 2, fy), footer, font=font_footer, fill="#9aa5b1")

canvas.save("../massarbeit-basis-pinout.png")
print(canvas.size)
