haki6661/massarbeit-waage/(commit log)

2026-08-30 Initial commit: Maßarbeit-Waage-Firmware
    HX711-Handling + Smart-Filter + NVS-Kalibrierung (portiert aus
    WeighMyBru2), NimBLE-Gewichts-/Akku-/Versionsservice mit Fernsteuerung
    des Displays durch die Handy-App, animierte Bootsequenz + Statusanzeige
    auf dem T-Display-S3-TFT, physische Taster-Bedienung, Deep-Sleep-
    Stromsparmodus, Firmware-Update direkt aus der App per BLE (OtaUpdater,
    kein WLAN am Partyort nötig) sowie Entwicklungs-OTA per WLAN für die
    aktive Codearbeit.
2026-08-30 Firmware-Manifest: MD5 korrigiert (fehlendes Zeichen beim Abtippen)
    md5sum lieferte 0c9f43224aeacf70044839326f35035b (32 Hex-Zeichen), im
    Manifest stand versehentlich nur 0c9f43224aeacf70044839326f35035 (31,
    letztes Zeichen fehlte) - waere auf der Waage an Update.setMD5()
    gescheitert. Beim automatisierten Testen aufgefallen (Manifest-
    Validierung in lib/firmwareUpdate.ts der App prüft auf exakt 32 Hex-
    Zeichen).
2026-08-30 Boot-Crash-Loop fixen (NimBLE-Mutex-Assert) + Display 180° gedreht
    Kritischer Fix: NimBLEDevice::setMTU() wurde vor NimBLEDevice::init()
    aufgerufen - setMTU() greift intern (ble_att_set_preferred_mtu) auf
    NimBLE-Host-Mutexe zu, die erst init() anlegt. Vor init() aufgerufen
    crashte das zuverlässig mit "assert failed: npl_freertos_mutex_pend
    ... (mu->handle)" direkt nach der Waagen-Initialisierung, noch bevor
    "[BLE] Initialisiere NimBLE..." geloggt wurde - Endlos-Boot-Loop. Per
    Serial-Log am ersten Batteriebetrieb aufgefallen. Fix: setMTU() jetzt
    nach init() aufgerufen.
    TftDisplay: Rotation von 1 auf 3 (180° gedreht, weiterhin Querformat
    320x170) - je nach Einbaulage des Boards.
    Firmware-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
2026-08-30 TFT-UI: Spieler-Badge + spielspezifische Away-Animationen, weniger Flackern
    - Neues BLE-Protokoll (0x14/0x15): App kann Aktiv-Spieler (Name, Farbe,
    Spiel) an die Waage schicken - zeigt sich als kleines Farb-/Namens-Badge
    oben auf dem Gewichtsscreen (renderPlayerBadge()), löst den bisherigen
    "Massarbeit Waage"-Titel ab, solange jemand am Zug ist.
    - Away-Kommando (0x13) trägt jetzt optional eine GameKind mit - eigene,
    ans jeweilige AwayMomentComponent der App angelehnte Animation je Spiel
    (Golf: Ball fliegt zur Fahne, Dart: Pfeil zur Scheibe, Blackjack: Karte
    wird gezogen/geflippt, Tower: Block wird rausgezogen), statt immer der
    gleichen generischen Ball-Animation.
    - Ergebnis-/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
2026-08-30 Kalibrierroutine robuster: Mittelwert-Rohwert, Plausibilitätsprüfung, bloßes Enter
    Scale::getRawValue() mittelt jetzt 10 Messungen statt nur einer - eine
    einzelne Messung kann bei normalem HX711-Rauschen (~100-150 Counts) leicht
    ein Ausreißer sein und der Kalibrierroutine einen deutlich falschen (auch
    falsch vorzeichenbehafteten) Faktor liefern, wie live passiert (Faktor
    -0.396 statt eines plausiblen positiven Werts).
    CalibrationRoutine speichert jetzt keinen Faktor <= 1.0 mehr - das deutet
    praktisch immer darauf hin, dass beim Ablesen kein/das falsche Gewicht auf
    der Waage stand, statt eines echten Kalibrierfaktors. Bricht stattdessen
    mit Fehlermeldung ab und lässt den bisherigen Fakt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
2026-08-30 Roadmap anlegen + .gitignore um lokale Tool-Artefakte ergänzen
    ROADMAP.md: erste zwei Punkte - Taste 1 kurz von Tara auf eine
    Spiel-Schnellauswahl umstellen, und die Bootsequenz beschleunigen/den
    "Starte..."-Text durch eine durchgehend laufende Animation ersetzen. Beide
    bewusst nur skizziert (offene Fragen dokumentiert), nicht umgesetzt.
    .gitignore: .claude/ (Session-/Tool-Metadaten, kein Projektinhalt).
2026-08-30 Firmware-Release 1.2.0
    Enthält seit 1.1.1: Spieler-Badge + spielspezifische Away-Animationen,
    weniger Flackern auf dem Gewichtsscreen, robustere Kalibrierroutine
    (gemittelter Rohwert, Plausibilitätsprüfung, bloßes Enter für die
    Leeren-Bestätigung).
2026-08-30 Pixel-Art-Sprite-Bootanimation statt Text + prozeduraler Balkenwaage
    Ersetzt die bisherige Bootsequenz ("Starte..."-Text, dann eine
    prozedural gezeichnete schwingende Balkenwaage + Boot-Checks) durch
    eine echte Pixel-Art-Sprite-Animation: 50 Frames (jeder 2. Frame eines
    100-Frame-Quell-GIFs, 320x170px), 8-Bit indiziert mit gemeinsamer
    256-Farben-Palette, endet mit dem "Maßarbeit"-Schriftzug.
    - Kein Text-Screen mehr davor - die Animation läuft sofort los.
    - Läuft parallel zur echten Initialisierung (runNextBootStep() in
    main.cpp erledigt battery/buttons/scale/BLE-Setup einen Schritt pro
    gezeigtem Frame) statt hinterher eine feste Dauer draufzuschlagen -
    ein normaler Boot dauert jetz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
2026-08-30 Firmware-Release 1.3.0 + Doku-Nachzug
    - README/ROADMAP: Sprite-Bootanimation dokumentiert (Projektstruktur,
    Bauen&Flashen inkl. uploadfs, BLE-Kommando-Tabelle war seit dem
    Spieler-Badge/Away-Animationen-Commit veraltet - 0x13 <gameId>,
    0x14/0x15 nachgetragen), ROADMAP-Punkt 2 als erledigt markiert.
    - Klarstellender Kommentar + README-Hinweis: ein BLE-Update ueberträgt
    nur die App-Partition, nie SPIFFS (data/boot/) - faellt bei fehlenden
    Frames sauber auf einen leeren Screen zurueck statt zu haengen.
    - Release-Binary + Manifest aktualisiert (enthaelt die Sprite-
    Bootanimation aus dem letzten Commit).
2026-08-30 Boot-Animation fixen: SPIFFS-Unterordner lieferten still 0 Byte
    Root Cause: /boot/pal.raw und /boot/f0XX.raw lagen in einem Unterordner.
    SPIFFS' stat() auf einen Pfad mit Unterordner kann fehlschlagen und faellt
    dann still auf einen (leeren) Directory-Handle zurueck - der zaehlt als
    "erfolgreich geoeffnet" (File-Objekt ist truthy), liefert bei read() aber
    0 Byte, ohne jeden Fehler. Ergebnis: Palette blieb komplett Schwarz
    (0x0000 an jeder Stelle) und der Frame-Puffer blieb uninitialisiert -
    das Boot-Log ueber USB sah dabei völlig unauffaellig aus (kein Fehler
    geloggt), das Display auf dem echten Geraet blieb aber durchgehend
    schwarz. Am Gerät reproduziert und mit einem direkten Farbfeld-Te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
2026-08-30 Auto-Zero-Nachfuehrung gegen thermische Drift bei leerer Waage
    Nutzer meldete: angezeigtes Gewicht wandert bei leerer Waage stetig weg
    (-2g -> -11,1g), obwohl korrekt kalibriert. Ursache: thermisches Ein-
    schwingen der Waegezelle/des HX711 nach dem Einschalten (typisch fuer
    guenstige Zellen, kein Firmware-Bug) - die Rohwert-Nulllage driftet
    ueber mehrere Minuten spuerbar.
    Firmware kann die physikalische Drift nicht verhindern, aber wie bei
    echten Kuechen-/Briefwaagen ueblich automatisch nachfuehren: liegt der
    gefilterte Wert laenger als 8s ruhig (Smart-Filter im STABLE-Zustand)
    innerhalb eines 10g-Bands um Null, wird automatisch nachtariert
    (hx711.tare(5) statt der vollen Scale::tare() - ke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
2026-08-30 ACTIVITY_THRESHOLD auf 4g angehoben - Auto-Zero griff nie
    Live am Geraet mit einem 949g-Referenzgewicht getestet (Serial-Debug-
    Log ueber ~35s): der Rohwert schwankt im Ruhezustand normal um ca.
    +/-1-3g pro Einzelsample. ACTIVITY_THRESHOLD stand aber bei 0.2g -
    weit darunter -, wodurch der Smart-Filter dauerhaft im BREWING-Zustand
    haengen blieb und NIE STABLE erreichte (0 von >100 Samples ueber 35s).
    Die erst kuerzlich eingebaute Auto-Zero-Nachfuehrung gegen thermische
    Drift (siehe Commit 98f3e15) ist an genau diesen STABLE-Zustand
    gekoppelt - sie griff also faktisch nie, und sich aufaddierende Drift
    blieb unkorrigiert liegen. Erklaert den gemeldeten Bug: nach mehreren
    Auflegen/Abheben-Zykl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
2026-08-30 Firmware-Release 1.3.3 (Scale-Aktivitaetsschwelle korrigiert)
    MD5/Groesse programmatisch aus dem finalen Release-Build berechnet und
    gegen das Manifest geprueft (nicht per Hand abgetippt):
    size: 1026880
    md5: 72d6a608c0aa9a8814c6173dfa84f343
2026-08-30 Firmware-Release 1.3.4 (Deep-Sleep-Aufwachen haengte sich auf + schnellere Nullpunkt-Korrektur)
    Zwei Bugs, gefunden per Live-Test:
    1. Aufwachen aus dem Deep Sleep ueber Taste 2 blieb in der Boot-Sprite-
    Animation haengen. Ursache: main.cpp prueft frueh in setup(), ob Taste
    2 beim Booten gehalten wird, um den Dev-OTA-WLAN-Modus zu aktivieren
    (DevOta::bootHeld()). Das Aufwachen selbst passiert aber GENAU ueber
    Taste 2 (ext0-Wakeup, siehe enterDeepSleep()) - die ist beim Hochfahren
    durch den Aufweck-Tastendruck zwangslaeufig noch gehalten (Loslassen
    braucht laenger als die 20ms-Entprellung in bootHeld()). Jedes
    Aufwachen startete dadurch faelschlich DevOta::begin() - block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
2026-08-30 Roadmap: Boxen-Zielwert wird reihum per Zufallsschluck vorgegeben (entschieden)
2026-08-30 Roadmap: neues Gehaeuse fuer die Waage entwerfen und drucken
2026-08-30 Roadmap: physische Guete-Anzeige fuer Golf wiederherstellen
    Golfs neuer Gruen-Reveal (massarbeit-app PR #20) hat getLiveDialConfig()
    fuer Golf auf immer-null gesetzt - Nebeneffekt: die Waage zeigt nach
    einem Golf-Schluck keine miss/close/perfect-Guete mehr auf ihrem Display
    (BLE-Kommando 0x12 wird nicht mehr gesendet). Als Folgeaufgabe fuer morgen
    festgehalten statt sofort mitgezogen.
2026-08-31 Roadmap: Golf-Gruen mit Pixel-Art-Texturen statt flachem Farbverlauf
    Passend zur neuen Pixelart-Fahnen-Sprite-Animation (massarbeit-app
    PR #20-#25) soll auch der Gruen-Untergrund selbst strukturiertes
    Pixel-Art-Terrain statt eines glatten CSS-Farbverlaufs bekommen -
    aktuell wirken Fahne und Untergrund stilistisch nicht zusammengehoerig.
2026-08-31 Firmware 1.4.0: Live-Gewichtsanzeige raus, Geraete-Spielauswahl rein (Roadmap 1)
    Groesserer Umbau der Display-/Tasten-Logik, ROADMAP.md Punkt 1:
    1. Reine Live-Gewichtsanzeige (bisheriger DisplayMode::Weight/Status,
    Taste 2 kurz zum Umschalten) komplett entfernt - war nur zum Debuggen
    gedacht (Rohwert/Akkuspannung), keine Spielrelevanz. DisplayMode als
    Enum entfaellt.
    2. Neu: Geraete-Spielauswahl als Ruhezustand des Displays (wenn weder ein
    RemoteCue laeuft noch ein Spieler am Zug ist). Taste 1 kurz schaltet
    durch die Spieleliste (PICKER_GAMES in TftDisplay.cpp, 1:1 synchron zu
    GAME_REGISTRY in gameRegistry.ts im App-Repo gepflegt - kein BLE-Sync,
    siehe offene Frage in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
2026-08-31 Roadmap: Punkt 1 (Geraete-Spielauswahl) als groesstenteils erledigt markiert
    App-Sync und automatischer BLE-Spieleliste-Abgleich bewusst als offene
    Ausbaustufen dokumentiert, nicht Teil dieses ersten Wurfs.
2026-08-31 Display: Ruhezustaende flackerten - unnoetiger periodischer Zwangs-Redraw
    Der Ruhezustands-Zweig von update() (Spielauswahl/Bestaetigt/Warteschirm,
    siehe Firmware 1.4.0) redrawte alle ~150ms komplett neu (fillScreen(BLACK)
    + alle Elemente), sobald das alte Zeit-basierte Throttle-Fenster ablief -
    auch wenn sich rein gar nichts geaendert hatte. Anders als beim frueheren
    Live-Gewicht (aendert sich fast jeden Tick, brauchte den periodischen
    Redraw wirklich) laeuft in keinem dieser drei Ruhezustaende irgendeine
    laufende Animation - der Redraw war rein verschwendet und erzeugte einen
    sichtbaren Schwarz-Blitz alle 150ms.
    Fix: periodische Zeit-Bedingung fuer den Ruhezustands-Zweig komplett
    entfernt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
2026-08-31 Boot-Sprite-Animation: feste Renderzeit pro Frame
    playBootSprite() lief bisher ungebremst - jeder Frame wurde direkt nach
    SPIFFS-Lesen + Zeichnen + stepInit() gezeigt, ohne Wartezeit. Dadurch
    schwankte die Abspielgeschwindigkeit spuerbar, je nachdem wie teuer der
    jeweils mitlaufende Init-Schritt war (z.B. bleService.begin() vs. ein
    guenstigerer Schritt).
    Fix: SPRITE_FRAME_DURATION_MS (100ms, = Framerate des Quell-GIFs, siehe
    BOOT_SPRITE_ASSETS.md) als benannte Konstante, Frame-Start merken und am
    Ende des Loop-Durchlaufs die Restzeit bis zum Budget abwarten. Frames,
    die laenger als das Budget brauchen, laufen einfach ohne Wartezeit
    weiter (kein Aufholversuch - wuerde nur ruckeln).
    Bewusst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
2026-08-31 Boxen: Geraete-Spielauswahl + Away-Animation ergaenzen (Firmware 1.4.1)
    Parity zum neuen App-Spiel 'Boxen' (siehe massarbeit-app): PICKER_GAMES,
    GameKind und die Away-Animationen sollen 1:1 synchron zu GAME_REGISTRY
    bleiben (siehe bestehender Kommentar in TftDisplay.cpp) - sonst zeigt
    die Waage fuer BLE-Kommandos mit gameId=6 nur den Golf-Fallback statt
    eines eigenen Boxen-Motivs.
    - GameKind::Boxen = 6 (TftDisplay.h), Config.h-Kommandoliste nachgezogen.
    - PICKER_GAMES: 'Boxen' zwischen Wackelturm und Scale (Reihenfolge 1:1
    zu GAME_REGISTRY in gameRegistry.ts).
    - renderGameIcon(): kleiner Boxhandschuh (Kreis + abgerundetes Rechteck).
    - renderAwayBoxen(): Boxsack + Handschuh-Jab als Hin-und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
2026-09-01 Firmware 1.5.0: TFT-UI an neues App-Design angeglichen, Flackern reduziert
    - Farbpalette 1:1 aus den neuen App-Design-Tokens uebernommen (dunkler
    Grund, ein Akzent 'Sonnenuntergang', success/danger/warning) statt der
    bisherigen Cafe-Kreide-Palette (ember/zest/cream/coral)
    - Je Spiel eine eigene Kennfarbe (identisch zu game.accent.solid im
    App-Repo) statt einheitlichem Oliv fuer alle Spiele-Icons
    - Kraeftige Bold-Schrift (FreeSansBold10pt7b) fuer Spielname/Cue-Titel
    statt des technischen 5x7-Pixel-Fonts, kleine Labels bleiben beim
    eingebauten Font
    - Flacker-Fix: renderRemoteCueScreen() (Bereit/Volltreffer/Nah dran/
    Daneben) und alle fuenf Away-Animationen (Golf/Dart/Blackjack/Towe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
2026-09-01 Roadmap: Geraetevariante "Waage Light" (ESP32-C3 ohne Display) festhalten (#10)
    Haelt die Architekturentscheidung und alle bereits recherchierten Details
    fuer die geplante Light-Variante fest, bevor sie wieder verloren gehen:
    - Grundsatzentscheidung mit Begruendung: EINE Firmware-Codebasis mit zwei
    Build-Targets statt zweier Projekte (S3 und C3 sind verschiedene
    Architekturen, eine .bin kann nicht auf beiden laufen - die echte Wahl
    ist eine Codebasis vs. doppelte Pflege bei ~90% geteiltem Code), plus
    EINE App, die das Modell zur Laufzeit ueber BLE erkennt.
    - Pinbelegung fuers C3-Board inkl. der drei Randbedingungen, die sie
    bestimmen (Strapping-Pins, nur GPIO0-5 RTC-faehig, USB/UA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
2026-09-01 Roadmap: geplante Pixel-Optik-Vorhaben streichen
    - Punkt 8 (Golf-"Gruen" mit Pixel-Art-Texturen statt flachem Farbverlauf)
    komplett entfernt.
    - Punkt 5 (Boxen): Abschnitt zur Lebensanzeige in Retro-Pixel-Optik auf dem
    Waagen-Display entfernt, die offene Frage nach der Stufung der
    Lebensanzeige bleibt ohne Vorgabe zur Darstellung bestehen.
    Unberuehrt bleiben die Erwaehnungen der bereits ausgelieferten
    Boot-Sprite-Animation (Punkt 2, Punkt 10) - die beschreiben vorhandenen
    Code, kein Vorhaben.
    Claude-Session: https://claude.ai/code/session_01CCNELLTft4ZkSvqeVkj2cx
2026-09-01 Roadmap: erledigte Punkte entfernen und neu sortieren
    Erledigtes wird ab jetzt geloescht statt als "erledigt" stehen zu bleiben -
    was live ist, steht im Code und in der Git-Historie.
    Entfernt:
    - Punkt 1 (Taste 1: Spiel-Schnellauswahl statt Tara, Firmware 1.4.0)
    - Punkt 2 (Boot beschleunigen, Firmware 1.4.0)
    - Punkt 5 (Spielmodus "Boxen") - der Status "Nicht begonnen" war veraltet:
    das Spiel ist in der App umgesetzt (Zielwert per Schluck des Vorgebers,
    Schaden aus der Abweichung, 100 HP, K.O./Battle-Royale) und in der
    Firmware mit Icon, Kennfarbe und Away-Animation vertreten.
    Gerettet: der offene Rest von Punkt 1 wird zu einem eigenen Punkt
    "App-Sync: Geraete-Spielauswahl schaltet die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
2026-09-01 Roadmap: Olympiade-Turniermodus ergaenzen
    Alle Spiele nacheinander als Disziplinen, Platzierungen werden ueber die
    Disziplinen hinweg mitgefuehrt, am Ende Treppchen mit Siegerehrungs-
    Animation.
    Festgehalten ist vor allem der architektonische Knackpunkt: GamePlugin
    (src/lib/types.ts im App-Repo) kann bisher nur EINEN Sieger melden
    (checkWinner -> WinnerResult), eine Olympiade braucht aber die
    vollstaendige Reihenfolge aller Spieler je Disziplin. Dazu, wie die
    einzelnen Spiele so eine Rangfolge ueberhaupt liefern koennen (Boxen ueber
    die K.O.-Reihenfolge, Scale gar nicht) und die offenen Fragen zu
    Punktesystem, Turnierstand, Reihenfolge, Gleichstand, Teams und Abbruch.
    Eingeordnet zu den ne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
2026-09-02 Boot-Animation: neues Dart/MassArbeit-Intro statt Tavernen-Sprite
    Neues Quell-GIF (animation/boot.gif, 640x360, 101 Frames) auf 320x170
    skaliert (gestaucht statt gecropped) und auf 47 statt 34 Sprite-Frames
    konvertiert - lokal per `pio run -t buildfs` als Maximum ermittelt, das
    noch in die SPIFFS-Partition passt (48 Frames schlagen fehl).
    - src/TftDisplay.cpp: FRAME_COUNT 34 -> 47
    - data/f000.raw..f046.raw + pal.raw neu erzeugt (gemeinsame 256-Farben-
    Palette, Floyd-Steinberg-Dithering, siehe BOOT_SPRITE_ASSETS.md)
    - animation/boot.gif als Quelle fuers Repo aufgenommen
    - BOOT_SPRITE_ASSETS.md aktualisiert (neue Quelle, Frame-Anzahl,
    Cropping-Entscheidung, Kapazitaets-Ermittlung)
    Firmwa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
2026-09-02 Firmware 1.6.0: BLE-Update deutlich schneller uebertragen
    Ein Firmware-Chunk wird mit Response geschrieben und kostet damit einen
    kompletten Round-Trip - die Uebertragungsdauer haengt fast linear am
    Verbindungsintervall. Die Advertising-Praeferenz aus begin()
    (setMinPreferred/setMaxPreferred, 7.5-22.5ms) ist nur ein Hinweis, den Android
    gern ignoriert und stattdessen ein sparsames Intervall im 30-50ms-Bereich
    waehlt. Eine explizite Parameter-Update-Anfrage wird dagegen praktisch immer
    akzeptiert: fuer die Dauer der Uebertragung jetzt 7.5-15ms anfordern, danach
    zurueck auf den sparsamen Normalbetrieb - ein dauerhaft schnelles Intervall
    kostet Akku.
    Dazu setDataLen(251): mit Data Length Exten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
2026-09-02 Firmware 1.7.0: zweite Geraetevariante "Waage Light" (LilyGO T7 v1.3 Mini32)
    Eine Codebasis, zwei Build-Targets. Die Light ist ein ESP32-Board ohne
    Display: sie wiegt und funkt, Rueckmeldung am Geraet gibt es nur ueber die
    Onboard-LED und Serial. Das Spielgeschehen laeuft ohnehin auf dem Handy.
    - include/BoardConfig.h wird zum Dispatcher, die Pins ziehen nach
    include/boards/ um. Jedes Board-Profil liefert zusaetzlich einen
    Faehigkeits-Steckbrief (MASSARBEIT_HAS_TFT/_BUTTON_COUNT/...), aus dem sich
    der restliche Code per #if zusammensetzt.
    - DeviceUi.h waehlt per Compile-Zeit-Typedef TftDisplay oder das neue
    LedStatusUi; RemoteCue/GameKind/LocalScreen wandern nach DeviceUiTypes.h.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
2026-09-02 Roadmap: Waage Light umgesetzt entfernen, offene Reste neu einsortieren
    Der Punkt "Zweite Gerätevariante: Maßarbeit Waage Light" ist erledigt (siehe
    Firmware 1.7.0 und den Modellerkennungs-Commit im App-Repo) und faellt
    deshalb raus - wie im Kopf dieser Datei festgelegt.
    Was daraus offen bleibt, steht jetzt als eigene Punkte da, statt in einem
    erledigten Abschnitt mitzuhaengen: hoerbare Rueckmeldung/Kalibrierung ohne
    Display, mehrere Waagen an einer App-Instanz, und das Light-Gehaeuse als
    Teil des Gehaeuse-Punktes. Erledigt und damit entfallen sind dagegen die
    Fragen nach dem konkreten Board (LilyGO T7 v1.3 Mini32) und nach Akku
    ja/nein (ja, Laderegler und JST-Buchse sind an Bord).
    Co-Au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
2026-09-02 Light-LED: Vollhelligkeit nicht mehr vom "noch nie gesetzt"-Marker schlucken
    lastLevel_ merkte sich die zuletzt geschriebene Helligkeit und startete mit
    0xFF als "noch nie gesetzt" - was als uint8_t nicht von der gueltigen
    Vollhelligkeit 255 zu unterscheiden ist. Ein allererstes setLevel(255)
    (Volltreffer direkt nach dem Verbinden) waere dadurch stillschweigend
    uebersprungen worden. Jetzt int16_t mit -1 als Marker.
2026-09-02 Firmware 1.7.1: Waage Light auf das richtige Board (LilyGO T-OI Plus, ESP32-C3)
    Das Board der Light war falsch angenommen: "mini D1 PLUS" ist der Silkscreen
    des LilyGO T-OI Plus V1.3 mit ESP32-C3 (RISC-V), nicht der eines T7 Mini32
    mit ESP32 im selben D1-mini-Format. Damit war das komplette Board-Profil
    falsch, und die als 1.7.0 veroeffentlichte Light-Firmware war ein
    Xtensa-Binary, das auf dem Geraet gar nicht erst gestartet waere.
    Pinbelegung jetzt aus LilyGOs eigenen Quellen statt aus dem Formfaktor
    geschlossen (Pinmap-Bild und example/battery_voltage im Repo
    Xinyuan-LilyGO/LilyGo-T-OI-PLUS, Arduino-Variante ttgo-t-oi-plus):
    HX711 auf GPIO6/7, Taster auf GPIO5, Status-LED GPIO3, Batterie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
2026-09-02 Scale: HX711-Endlos-Hang bei fehlender Waegezelle beheben
    hx711.begin() ruft mit doReset=true (Library-Default) intern
    reset() -> read() auf, was blockierend auf eine LOW-Flanke an DOUT
    wartet. Ohne angeschlossenen HX711 (DOUT haengt per Pullup dauerhaft
    HIGH) haengt sich das Geraet damit noch vor dem eigentlichen,
    zeitlich begrenzten Verbindungstest fuer immer auf - kein Crash,
    kein Watchdog-Reset, einfach stiller Stillstand.
    Auf echter Hardware (Waage Light, ESP32-C3) reproduziert: Boot blieb
    nach "Kalibrierfaktor geladen" fuer 40s+ ohne jede weitere Ausgabe
    stehen. Mit doReset=false laeuft der 3s-Verbindungstest wie
    vorgesehen durch, danach startet BLE/Advertising normal.
    Betraf latent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
2026-09-02 Firmware 1.8.0: Modelle heissen jetzt "Massarbeit" und "Massarbeit Vision"
    Die Variante ohne Display ist das Basismodell und heisst schlicht
    "Massarbeit"; die bisherige "Massarbeit Waage" mit TFT wird zur "Massarbeit
    Vision". Im Code heissen die beiden durchgehend kurz "Vision" und "Basis"
    (Makros MASSARBEIT_VARIANT_VISION/_BASE statt _PRO/_LIGHT).
    Was sich mitaendert:
    - BLE-Geraetename: "Massarbeit-Vision" bzw. "Massarbeit"
    - Modellkennung und Manifest-Schluessel: light-c3 -> t-oi-plus. Die Kennungen
    benennen ab jetzt bewusst die HARDWARE, nicht das Produkt - unter ihnen
    sucht die App im Manifest das passende Release, sie muessen also stabil
    bleiben, auch wenn ein Produktname sich wi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
2026-09-02 Firmware 1.8.1: Geraete-Info kam als 4 Byte Zeigeradresse statt als JSON an
    Symptom: eine verbundene Basis meldete sich in der App als "Maßarbeit
    Vision" - und haette damit beim naechsten Update das Binary der falschen
    Architektur angeboten bekommen.
    Ursache: deviceInfoChar_->setValue(deviceInfo.c_str()). Das sieht richtig
    aus, schreibt aber 4 Byte Zeigeradresse. NimBLECharacteristic::setValue(const
    T&) reicht an NimBLEAttValue::setValue<T>(s) mit EXPLIZITEM Template-Argument
    weiter; damit kommt die passende const-char*-Ueberladung (die strlen()
    benutzt) gar nicht mehr in Frage und es greift das Fallback-Template "Typ
    ohne c_str()" -> memcpy(&s, sizeof(T)). Die App las Datenmuell, JSON.par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
2026-09-03 Pinout-Diagramme fuer beide Geraetevarianten hinzufuegen
    SVG-Diagramme unter docs/pinout/ fuer Massarbeit Vision (T-Display S3)
    und Massarbeit Basis (T-OI Plus), im README unter den bestehenden
    Pin-Tabellen verlinkt.
2026-09-03 Pinout-Diagramme durch annotierte Herstellerfotos ersetzen
    Die frueheren SVG-Funktionsdiagramme zeigten alle GPIO-Zuordnungen
    (inkl. fest verdrahteter Onboard-Funktionen wie Taster, Display,
    Batterie-ADC). Ersetzt durch annotierte Ausschnitte der offiziellen
    LilyGO-Pinout-Fotos, die nur die tatsaechlich extern zu verkabelnden
    Header-Pins markieren:
    - Vision (T-Display S3): HX711 VCC/DOUT/SCK/GND
    - Basis (T-OI Plus): HX711 VCC/DOUT/SCK/GND + externer Taster
    Pixelkoordinaten der Pads wurden am Original-Bildmaterial vermessen
    (docs/pinout/src/, inkl. Regenerierungs-Skripte generate_vision.py /
    generate_basis.py und den unveraenderten LilyGO-Quellbildern).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
2026-09-03 Battery: Akkustand-Anzeige beruhigen (ADC-Rauschen gefiltert)
    Ein einzelnes 12-Bit-ADC-Sample alle 5s reichte an einer Stufe der
    Entladekurve (Battery::readPercent()) schon bei 10-15mV Rauschen fuer
    einen sichtbaren Prozentsprung - sichtbar als Hin-und-Her (z.B. 79/81)
    in der App. Battery::readVoltage() mittelt jetzt 32 ADC-Samples pro
    Messung (Oversampling) und glaettet zusaetzlich ueber aufeinander-
    folgende Aufrufe mit einem exponentiell gleitenden Mittelwert
    (alpha=0.25). Wird ein ungueltiger Messwert erkannt (USB gesteckt,
    kein Akku), setzt sich der Filter zurueck, damit ein spaeter wieder
    gueltiger Wert nicht erst einschwingen muss.
    Verifiziert per BLE-Live-Verbindung zur Basisvariant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
2026-09-03 Firmware-Release 1.8.2 (Akkustand-Filter)
    Version hochgezaehlt und beide Varianten neu gebaut, damit der
    Akkustand-Filter aus f7b2571 (Battery: Akkustand-Anzeige beruhigen)
    per BLE-OTA an bestehende Waagen verteilt werden kann.
2026-09-03 Roadmap: WS2812B-RGB-LED-Ring im Deckel für visuelle Cues
2026-09-03 Kalibrierung per App: BLE-Kommandos für Rohwert lesen + Faktor setzen (#12)
    Ergänzt zwei neue Kommandos auf der Command-Characteristic:
    - 0x20 (GET_RAW): misst den HX711-Rohwert (Mittel aus 10 Messungen,
    wie CalibrationRoutine.cpp) und meldet ihn über die neue
    BLE_CALIBRATION_CHAR_UUID (int32 LE) zurück.
    - 0x21 (SET_FACTOR): setzt einen neuen Kalibrierfaktor und speichert
    ihn dauerhaft im NVS (Scale::set_scale()), inkl. derselben
    Plausibilitätsprüfung wie die bisherige Serial-Kalibrierroutine.
    Damit lässt sich dieselbe Kalibrierung, die bisher nur über USB +
    Serial Monitor + Taster ging (CalibrationRoutine.cpp, bleibt als
    Fallback erhalten), jetzt auch direkt aus der App fah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
2026-09-03 Roadmap nach Repo sortiert: nur noch Geraetethemen hier
    Die beiden Roadmaps (diese und der Abschnitt "Roadmap" in PRODUCT.md des
    App-Repos) hatten sich vermischt - App-Vorhaben standen hier bei der
    Firmware. Beide Koepfe nennen jetzt dieselbe Faustregel: wo muesste man
    tippen, um den Punkt zu erledigen? Eine .cpp, ein Pin, ein Kommando-Byte
    hierher; ein Spiel, ein Store, ein Screen ins App-Repo. Punkte, fuer die
    beide Seiten etwas tun muessen, stehen dort, wo der Knackpunkt liegt, und
    nennen die andere Haelfte ausdruecklich.
    Ins App-Repo gewandert: Eingiess-Modus, Olympiade und "mehrere Waagen an
    einer App-Instanz" - bei allen dreien liegt die eigentliche Arbeit in der
    App (beim letzten ist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
2026-09-04 Firmware-Releases automatisch per GitHub Actions bauen (#13)
    Bisher musste firmware/manifest.json + firmware/*.bin nach jeder
    FIRMWARE_VERSION-Änderung von Hand mit installiertem PlatformIO
    gebaut und gepusht werden (scripts/release.py) - leicht vergessen,
    wodurch die App ein veraltetes oder gar kein Update anbietet.
    Neuer Workflow .github/workflows/release-firmware.yml baut bei jeder
    Änderung an include/Config.h (typischerweise ein Versionsbump) beide
    Firmware-Varianten, aktualisiert firmware/ und committet/pusht das
    Ergebnis selbst zurück auf main. Der Pfadfilter auf genau Config.h
    verhindert eine Endlosschleife, da der automatische Commit nur
    firmware/ anfasst. Zusätzlich per workflo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
2026-09-04 release.py: argparse-Bug beim Aufruf ohne Variante beheben (#14)
    nargs="*" zusammen mit choices ist eine bekannte argparse-Kuriosität:
    ohne übergebenes Argument validiert argparse die leere Liste selbst
    gegen choices statt (mangels Elementen) gar nichts zu prüfen, und
    bricht mit "invalid choice: []" ab - genau der Normalfall "ohne
    Argumente = beide Varianten bauen" (siehe README, "Release bauen").
    Betraf sowohl den lokalen Handbetrieb als auch den neuen
    release-firmware.yml-Workflow (#13), dessen allererster Lauf genau
    daran gescheitert ist, ohne überhaupt bis zum PlatformIO-Build zu
    kommen.
    choices dafür entfernt, Validierung stattdessen von Hand nach dem
    Parsen - mit derselben Fehle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
2026-09-05 WS2812B-LED-Ring vorbereitet einbauen (ausgeschaltet) (#15)
    Gruest fuer einen adressierbaren 5V-RGB-Ring (WS2812B) im Deckel, wie in
    ROADMAP.md Punkt 6 beschrieben - vollstaendig eingebaut, aber in beiden
    Board-Profilen ausgeschaltet (MASSARBEIT_HAS_LED_RING = 0).
    src/LedRing.h/.cpp enthaelt die komplette Lichtlogik:
    - Startampel "Formel 1": fuenf rote Lampen gehen nacheinander an, bleiben
    stehen, gehen gemeinsam aus ("lights out"), danach gruener Umlauf. Beide
    Varianten der offenen Frage aus ROADMAP-Punkt 1 sind moeglich - Haltezeit
    mitgeben (Waage lost aus) oder Gruen von aussen setzen (App lost aus).
    - Dieselben Zustaende wie Display/Status-LED, in derselben Rangfolge:
    HX711-Feh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
2026-09-06 LED-Leiste auf der Basis in Betrieb nehmen, HX711-Standby, Auto-Sleep raus (#16)
    * HX711 vor dem Deep Sleep schlafen legen (Faktor ~7 Standby-Zeit)
    Der schlafende ESP32 zieht nur wenige µA - der HX711 lief bisher mit
    ~1.4-1.6mA unbeeindruckt weiter und war damit im Schlaf der mit Abstand
    groesste Verbraucher der ganzen Schaltung. An einer 700mAh-Zelle ist das der
    Unterschied zwischen rund zwei Wochen und mehreren Monaten Standby.
    - Scale::powerDown() schickt den HX711 in den Standby (~0.3µA), direkt ueber
    den Takt-Pin nach Datenblatt (PD_SCK >60µs HIGH) statt ueber die Library.
    - enterDeepSleep() ruft das auf und friert HX711_SCK ueber den Schlaf hinweg
    ein (gpio_hold_en + gpio_deep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
2026-09-06 Formel-1-Startampel: BLE-Kommandos fuer die LED-Leiste/den -Ring (#1)
    LedRing::startRaceLights()/raceLightsGreen()/abortRaceLights() waren
    bereits fertig, aber nicht ansteuerbar - jetzt ueber drei neue
    Kommandos auf der Command-Characteristic verdrahtet:
    - 0x30 <uint16 LE holdMs>: Startampel starten. Fuenf rote Lampen gehen
    nacheinander an, bleiben holdMs stehen und gehen danach von selbst
    gemeinsam aus (gruener Umlauf folgt automatisch) - kein zweites
    Kommando noetig. holdMs = 0 heisst "App gibt Gruen selbst".
    - 0x31: sofort Gruen erzwingen.
    - 0x32: Fehlstart/Abbruch (rotes Warnblinken).
    DeviceUi (TftDisplay/LedStatusUi) bekommt dafuer drei duenne
    Weiterreich-Methoden, die an den an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
2026-09-06 Taster von der Basis entfernen - Bedienung komplett über die App (#17)
    Der Taster ist nicht mehr verbaut: ein und aus macht der Schiebeschalter des
    Boards (bzw. ein extern parallel dazu gelegter), alles andere die App. Damit
    faellt auf der Basis nicht nur die Tastenlogik weg, sondern auch der Deep
    Sleep - ohne Aufweck-Taster gaebe es keinen Weg zurueck.
    - MASSARBEIT_BUTTON_COUNT der Basis auf 0. Daran haengt jetzt alles:
    Tastencode, Deep Sleep und AUTO_SLEEP_TIMEOUT_MS. Das gestern eingefuehrte
    MASSARBEIT_HAS_WAKE_BUTTON entfaellt wieder - es sagte dasselbe zweimal.
    - Pins::BUTTON_1/WAKEUP_BUTTON aus dem Basis-Profil entfernt; GPIO5 ist
    wieder frei und als solcher vermerkt.
    - enterDe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
2026-09-06 Veraltete Kommentare und Doku-Hinweise richtigstellen (#18)
    Reine Kommentar-/Doku-Aenderung, kein Code angefasst (per Diff geprueft:
    im src/- und include/-Anteil aendern sich ausschliesslich Kommentarzeilen).
    Was nicht mehr stimmte:
    - LedRing.h behauptete, fuer die Startampel fehle "noch die
    Protokollhaelfte, die diese Methoden von der App aus ausloest" - die gibt
    es seit den BLE-Kommandos 0x30-0x32. Ausserdem verwies der Kommentar auf
    den alten Roadmap-Titel "Formel 1 auf dem Geraet nachziehen"; der Punkt
    heisst inzwischen "Formel 1 auf der Vision (TFT) nachziehen".
    - Config.h: das Geraete-Info-Beispiel zeigte fw 1.8.1 und "buttons":1 - die
    Basis hat seit dem Taster-Ausbau 0 Tas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
2026-09-10 LED-Leiste an die App-Animationen angeglichen: Startampel mit 4 Lampen im App-Takt (#19)
    Startampel (Formel 1):
    - Vier Lampen statt fuenf, jede Lampe genau zwei LEDs breit (8er-Leiste;
    auf einem 16er-Ring vier LEDs mit dunkler Fuge).
    - Gleicher Takt wie die App: Lampe n geht bei n * Intervall an (die erste
    nach einem Intervall, nicht sofort), 700 statt 900ms. Vorher ging die
    Waage rund eine Sekunde nach dem Bildschirm auf Gruen.
    - 0x30 nimmt optional Lampentakt und -zahl mit (<holdMs><intervalMs><count>),
    die App schickt beide - es gibt nur noch eine Wahrheit fuer den Takt.
    - Gruen = alle Lampen schlagen gleichzeitig auf Gruen um (wie die App),
    statt Ausgehen + gruenem Umlauf. Grue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
2026-09-10 Firmware-Version 1.11.0 (LED-Leiste an die App-Animationen angeglichen, #19) (#20)
    Ohne Hochzaehlen bot die App das Update nie an: sie vergleicht die
    Release-Version mit der auf der Waage (isNewerVersion), und der
    automatische Release nach #19 trug weiter 1.10.0.
2026-09-10 HX711/Wägezelle überwachen + Status per BLE, Regenbogen im Leerlauf (1.12.0) (#21)
    * HX711 und Waegezelle im Betrieb ueberwachen, Status per BLE an die App (1.12.0)
    Bisher wurde der HX711 nur beim Booten geprueft: ein im Betrieb
    abgezogener HX711 liess das letzte Gewicht einfach stehen, eine fehlende
    Waegezelle fiel gar nicht auf (die Anschlagwerte des ADC gingen als
    absurde Gewichte an die App).
    Scale ueberwacht jetzt laufend (SensorStatus):
    - HX711 weg: 1,5 s ohne neuen Messwert (DOUT bleibt HIGH) oder zehn
    glatte Nullen in Folge (DOUT haengt auf LOW).
    - Waegezelle weg: Rohwerte 1 s lang am Anschlag (+/-2^23) - mit Zelle
    kommt das nie vor. Anschlagwerte gehen gar nicht erst in den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
2026-09-10 HX711-Fehlalarm: Watchdog-Stempel an allen Direktmessungen (1.12.1)
    Die Waage meldete "HX711 antwortet nicht", obwohl der Chip fest verloetet
    war und einwandfrei mass - in der App als Warnbanner, auf dem LED-Ring als
    drei rote Blitze.
    Ursache: der Laufzeit-Watchdog aus 1.12.0 merkt sich in lastReadyMs, wann
    der HX711 zuletzt geantwortet hat, und schlaegt nach HX711_LOST_TIMEOUT_MS
    (1,5 s) Alarm. Gestempelt wurde aber nur in getWeight() selbst - die
    anderen Stellen, die den Chip direkt lesen, blockieren laenger als das
    Timeout und liessen den Stempel veralten:
    hx711.tare(20) 1838 ms gemessen (10 SPS) App-Tara, BLE 0x01
    getRawValue() ~900 ms, mehrmals pro Sek. Eich-Bildschirm der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
2026-09-10 Nullpunkt-Korrekturen loggen statt lautlos verschieben (1.12.2)
    Die Auto-Zero-Nachfuehrung in getWeight() hat den Nullpunkt bisher voellig
    lautlos verschoben - keine einzige Log-Zeile. Beim Debuggen am 10.09. war
    deshalb im Serial-Log nur die WIRKUNG sichtbar (die App wertete Schlucke,
    die niemand getrunken hatte, und meldete aufgestellte Glaeser auf leerer
    Waage), waehrend die Ursache unsichtbar blieb. Erst die Gegenrechnung ueber
    zwei Logs hinweg brachte sie ans Licht.
    Jetzt loggt sie Korrekturen ab 1 g mit Betrag; darunter bleibt sie still,
    sonst kaeme alle 8 s eine Zeile fuers normale Nachziehen der Temperaturdrift.
    Die Schock-Korrektur direkt darunter loggte zwar schon, aber ohne Zahl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
2026-09-10 LED-Muster aufraeumen: von zehn auf sieben, keine zwei mehr verwechselbar (1.13.0)
    Der Ring zeigte zehn Muster, und mehrere davon waren aus zwei Metern
    Partylicht nicht auseinanderzuhalten - "gruener Puls" gegen "gruener
    Umlauf", "roter Abfall" gegen "drei rote Blitze". Was bleibt, ist ein
    Zustand pro Muster, und jedes unterscheidet sich in Bewegung UND Farbe.
    Weg:
    - Der mitwachsende Gewichtsbalken. Er belegte den Ring waehrend des
    gesamten Zugs und ueberdeckte damit ausgerechnet die Anzeige, auf die es
    ankommt: wer am Zug ist. setWeight() bleibt, die Startampel erkennt am
    Gewicht, wann das Glas hochgerissen wurde.
    - Die drei Guete-Cues (Volltreffer/nah dran/daneben). Die Zahl steht g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
2026-09-27 BLE-Kommandos in loop() abarbeiten statt im NimBLE-Task (1.13.1)
    onWrite() laeuft im NimBLE-Host-Task, nicht in loop(). Alle App-Kommandos
    wurden bisher direkt dort ausgefuehrt:
    - Tara (0x01) und Rohwert-Messung (0x20) takteten den HX711 damit
    gleichzeitig mit scale.getWeight() in loop() an - zwei Tasks am selben
    Bit-Bang-Takt verstuemmeln die Messwerte, und waehrend der ~1,8 s langen
    Tara sah loop() keinen Messwert mehr und konnte "HX711 verloren" melden.
    - Die Anzeige-Kommandos (Spieler-Badge mit String, Cues, Startampel)
    schrieben Zustand, den loop() im selben Moment zum Zeichnen las.
    Jetzt stellt onWrite() das Kommando nur in eine FreeRTOS-Queue, und
    update() arbeitet sie in lo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
